DorvanFavre/dorvan/Babydoll/assets/Pasted image 20241222143701.png

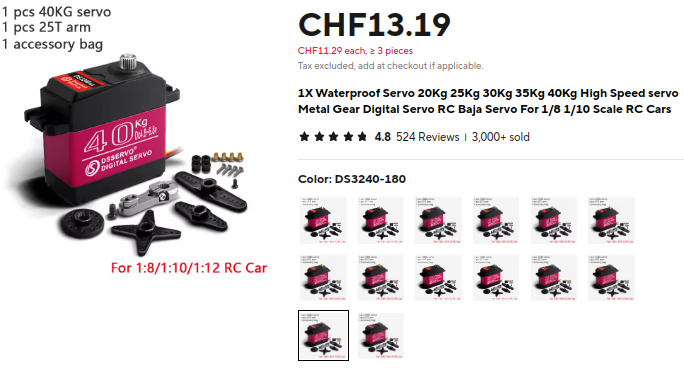
Babydoll/assets/Pasted image 20241222143701.png
