DorvanFavre/dorvan/Babydoll/Pasted image 20250105163903.png

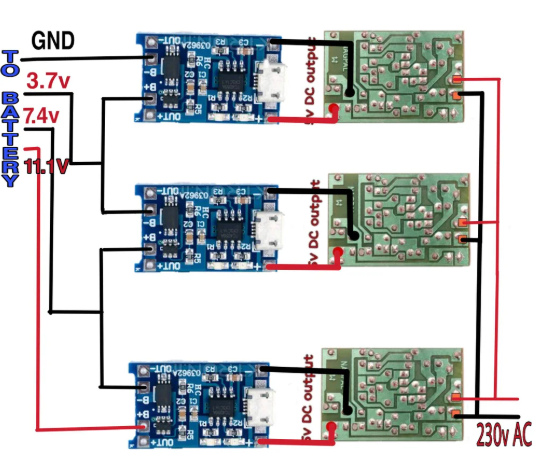
Babydoll/Pasted image 20250105163903.png
