DorvanFavre/dorvan/Babydoll/Design Hexapod.md

Servo 996R
6V : 1.3 A 

Battery:
1.3 A x 18 = 23.4 A

- [ ] Multimètre
- [ ] Fer à souder
- [ ] Soudure 
- [ ] Tresse à débraser 
- [ ] 18 servo 
- [ ] Câbles 
- [ ] Connecteurs
- [ ] roulement à bille 
- [ ] Régulateur x2 YPG 
- [ ] Chargeur de batterie
- [ ] Level converter 
- [ ] PCA9685 channel
- [ ] LM2596 régulateur 

- [ ] PLA
- [ ] Batterie
