DorvanFavre/dorvan/Babydoll/Produits/Babybot-01/Mechanical-02/Motors.md

**DS3240-180**

https://probots.co.in/ds3240-pro-40kg-high-torque-servo-motor-waterproof-metal-gear.html

![[Pasted image 20241222143701.png]]
![[Pasted image 20250108115026.png]]

Brand:Dsservo
Packing List:
1x digital servo
1x 25T adjustable metal servo arm
1x accessory bag
Apply Environmental Conditon:
1.Storage Temperature Range:-30°C~80°C
2.Operating Temperature Range:-25°C~70°C
Mechanical Specification:
1. Size: 40.0*20.5*40.5mm
2. Weight: 58g±2g
3. Limit angle: 360°
4.Bearing: 2BB
5.Horn gear spline: 25T   Diameter:5.9mm
6.Case : Engineering plastics+Aluminum alloy
7.Connector wire: 320mm±5mm
8.Motor: Carbon brush motor
Electrical Specification:
1.Working voltage range:  4.8 - 6.8V
2.Command signal: Pulse width modification
3.Amplifier type: Digital controller
4.Pulse width range: 500～2500usec
5.Neutral position: 1500usec
6.Running degree: 180±3°(PWM 500～2500usec)
or 270±3°(PWM500～2500usec)
7.Dead band width: 3 usec
8.Rotating direction Counterclockwise: (when 1000～2000usec)
## Ressources

Make your pet
https://www.youtube.com/watch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

## Test

Voltage: 6v
180 deg at full speed, no load:
3A the first 30ms
400mA afterward
env. 800ms to do 180deg

Add load draws mor current (obvious)
with quite some strength (block half the speed), draw 1A
