DorvanFavre/dorvan/Babydoll/Produits/Babybot-01/Mechanical-01/Investigate projects.md

Website to explore from:
- https://www.thingiverse.com/
- https://hackaday.io/project/171456-diy-hobby-servos-quadruped-robot

Exapode from Aecert Robotics: https://youtu.be/u-U2VmCW-e8?si=5wC6ucCFXUlxmgS2

Kit : https://www.robotshop.com/collections/hexapod-development-platforms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

 Hiwonder JetHexa ROS Hexapod Robot : 1200$

Battery: 
- 3500mAh 5C Lipo battery

Used servos:
3 per leg
20kg
HX-35H itelligent serial bus servo, Hiwonder

Bus servo controller 

Used controller:
- Arduino
- RaspberryPi 4
- Jetson nano 

Guide : https://www.esolutions.tech/how-to-build-a-hexapod-part-1-mechanics
- [ ] Look other guys 

Hexapod from MarkWTech:  https://markwtech.com/robots/hexapod/ 

Servo :
- MG996R

Level converter 

Hexapod from Leptan: https://project-leptan-docs.readthedocs.io/en/latest/index.html

Make your pet : https://github.com/MakeYourPet/hexapod/tree/main
