DorvanFavre/dorvan/Babydoll/Produits/Babybot-01/Mechanical-01/Learn inverse kinematic.md

### Ressources

Forward kinematic
https://irisdynamics.com/articles/forward-and-inverse-kinematics

https://blog.robotiq.com/how-to-calculate-a-robots-forward-kinematics-in-5-easy-steps

inverse Kinematics
https://youtu.be/D93iQVoSScQ?si=YG3vr2P5hCK57BNu
