DorvanFavre/dorvan/Babydoll/Produits/Babybot-01/Mechanical-02/Power.md

4 options:
- Contact-Based Docking Station
- Wireless Inductive Charging
- Solar charging
- Hybrid approach

## Wireless Inductive Charging

- Inductive charging module (transmitter and receiver coil)
- LiPo charging controller
- Alignment sensors (e.g., IR, ultrasonic, or camera-based)
- Temperature monitoring components (optional but recommended)

### DIY
https://www.instructables.com/DIY-Wireless-Charger-1/
https://www.instructables.com/Inductive-Charging-a-Simple-Approach-TfCD/
