DorvanFavre/dorvan/Babydoll/Produits/Babybot-01/Mechanical-02/Design Quadruped(Fusion360)/8. Design leg (Fusion 360).md

**Parameters**

Fixed components sizes (Servo, battery, screws, nuts)
Keys dimensions (member length)
Arbitrary dimensions (wall thickness, clearances)

**Components dimensions**

Battery (length, width, height): 140, 25.5, 47
Servo (length, width, height) : 40,20, 41
Servo hole distance : 4.5
Spline height: 7.9
Ballring (Outer diameter, inner diameter, width) : 11, 5, 5
Screw hole diameter: 2.2

**Key dimensions**
Coxa length: 40
Femur length: 80
Tibia length : 120

**Arbitrary diensions**

Spline clearance: 10
body spacements: 0.5
Scree clearance wall: 1.5 + screw radius
Wall thickness : 5
