DorvanFavre/dorvan/Babydoll/Organisation/Organisation.md

**Investigate**
Explore web, read paper, watch video, take note

**Learn**
Follow specific course

Title must be an objective that can be marked as done. 
"learn" is too vague. 
Choose instead:
- Power Jetson with battery
- Train agent to walk forward
- Rewrite environment according to standards
- Follow the first FlyEnv tutorials
- Find a paper that talks about CPG
