DorvanFavre/dorvan/Babydoll/Produits/Babybot-01/Informatic-01/Use camera.md

https://developer.nvidia.com/embedded/learn/jetson-orin-nano-devkit-user-guide/howto.html
camera v1.3 not working. buying v2.1
