DorvanFavre/dorvan/Babydoll/Produits/Babybot-01/Informatic-01/Credentials.md

**Jetson orin nano**
username: dorvan
password: 6956
