DorvanFavre/dorvan/Babydoll/Produits/Babybot-01/Informatic-01/Investigate VAE.md

D. Yarats, A. Zhang, I. Kostrikov, B. Amos, J. Pineau, and R. Fergus. Improving sample effi-
ciency in model-free reinforcement learning from images. arXiv preprint arXiv:1910.01741,
2019.
