DorvanFavre/dorvan/Babydoll/Produits/Babybot-01/Informatic-01/Informatic-01.md

The objective is to **train** an **RL model** to produce a simple **walk** in **simulation** and deploy it on the actual robot.

Materials
Crawling robot: https://github.com/krcarter/Reinforcement-Learning-Crawling-Robot

multiplyTransforms
changeDynamics

## Memo
