DorvanFavre/dorvan/Babydoll/Produits/Babybot-01/Informatic-01/Simulate robot and walk with IK/Simulate robot and walk with IK.md

The function `p.multiplyTransforms()` in PyBullet is used to **transform a position and orientation from one coordinate frame to another**. Specifically, it transforms a point from one frame (e.g., the robot's base frame) to another (e.g., the world frame).

### Syntax:
```python
new_position, new_orientation = p.multiplyTransforms(
    positionA, orientationA, positionB, orientationB
)
```

### Parameters:
- **`positionA`**: The position of a point in frame A (e.g., the robot’s base frame). This is a list or tuple of three values: `[x, y, z]`.
- **`orientationA`**: The orientation of frame A in quaternion format `[x, y, z, w]`. This represents the rotation of frame A relative to some reference frame.
- **`positionB`**: The position of the point in frame B that you want to transform to frame A. This is also in the form `[x, y, z]`.
- **`orientationB`**: The orientation of frame B in quaternion format `[x, y, z, w]`.

### Output:
- **`new_position`**: The transformed position in the world frame (or the frame to which you're transforming).
- **`new_orientation`**: The transformed orientation in the world frame (or the frame to which you're transforming).

### Explanation:
`p.multiplyTransforms()` applies a transformation to a position and orientation from one coordinate system (frame) to another. Here's what it does step-by-step:

1. **Rotation**: It applies the rotation of `orientationB` (frame B’s orientation) to the point in `positionB`.
2. **Translation**: It then adds the position `positionA` (frame A’s position) to the rotated point, thus transforming the point into frame A's coordinate system.

This is helpful when you want to move points or objects between coordinate systems. For example:
- Transforming a position from the robot’s base frame to the world frame.
- Combining transformations to get the final position of an object after multiple transformations.

### Example:

Imagine the robot's base frame has a position `[1, 1, 0]` and an orientation of `[0, 0, 0, 1]` (no rotation, i.e., it's aligned with the world frame). If you want to transform a point `[0.5, 0.5, 0]` in the robot's base frame into the world frame, you can do:

```python
base_position = [1, 1, 0]  # Robot's base position in world frame
base_orientation = [0, 0, 0, 1]  # Robot's base orientation (no rotation)
point_in_base = [0.5, 0.5, 0]  # Point in the robot's base frame
point_orientation = [0, 0, 0, 1]  # No rotation for the point

# Transform the point to the world frame
transformed_position, transformed_orientation = p.multiplyTransforms(
    base_position, base_orientation, point_in_base, point_orientation
)

print(f"Transformed Position: {transformed_position}")
```

This will give you the point's new position in the world frame, taking into account the robot's base position and orientation.
