DorvanFavre/dorvan/Babydoll/Produits/Babybot-01/Informatic-01/LearnJetson/JetsonPytorch/JetsonPytorch.md

Use pytorch on Jetson

- [ ] Cartpole with DQN tutorial 
https://pytorch.org/tutorials/intermediate/reinforcement_q_learning.html
