DorvanFavre/dorvan/Babydoll/assets/Pasted image 20241118151543.png

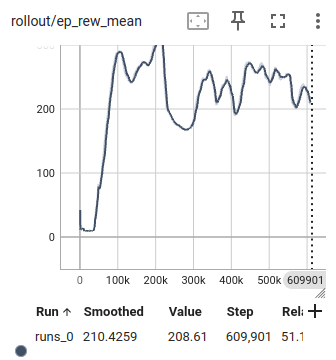
Babydoll/assets/Pasted image 20241118151543.png
