DorvanFavre/dorvan/Babydoll/assets/Pasted image 20241118154440.png

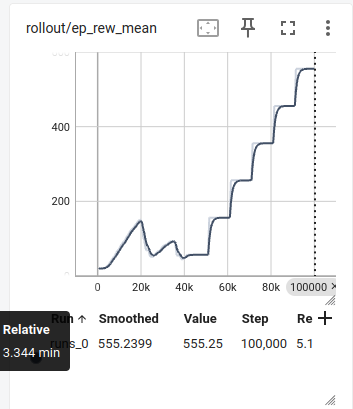
Babydoll/assets/Pasted image 20241118154440.png
