DorvanFavre/dorvan/Babydoll/assets/Pasted image 20241118185245.png

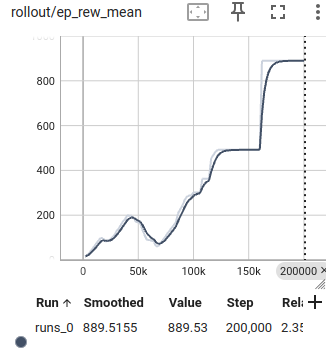
Babydoll/assets/Pasted image 20241118185245.png
