DorvanFavre/dorvan/Babydoll/assets/Pasted image 20241118190923.png

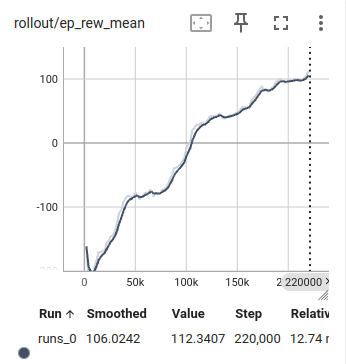
Babydoll/assets/Pasted image 20241118190923.png
