DorvanFavre/dorvan/Babydoll/assets/Pasted image 20241120112606.png

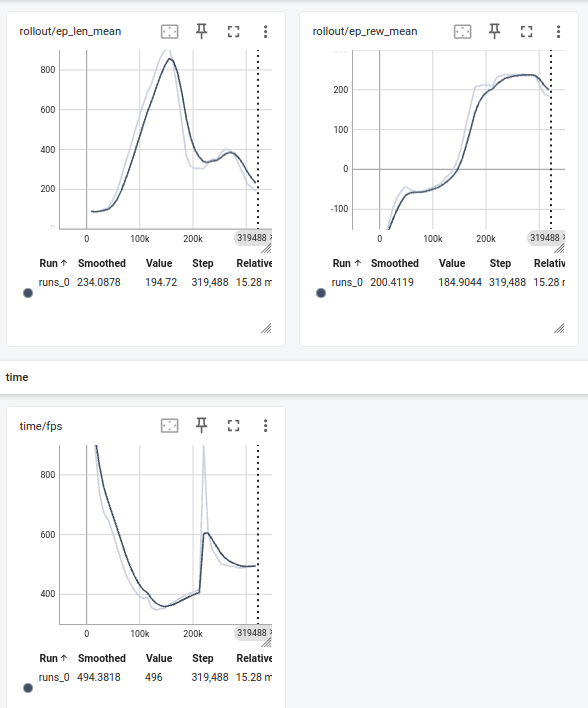
Babydoll/assets/Pasted image 20241120112606.png
