DorvanFavre/dorvan/Babydoll/assets/Pasted image 20241120125008.png

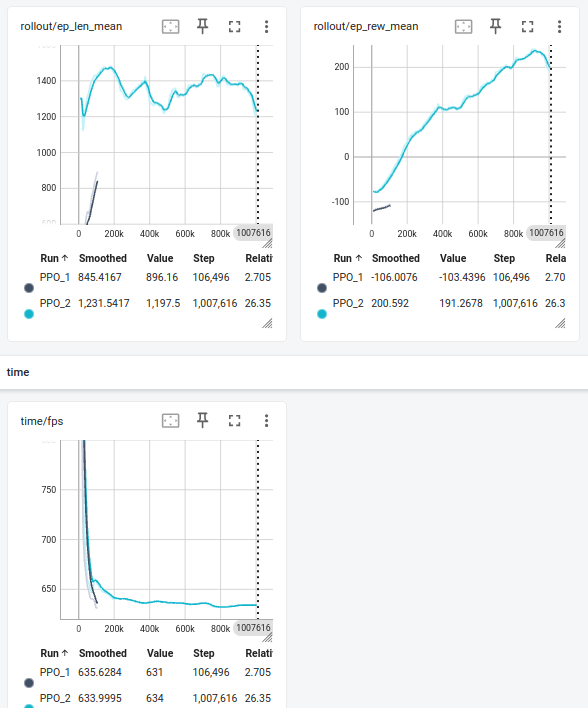
Babydoll/assets/Pasted image 20241120125008.png
