DorvanFavre/dorvan/Babydoll/assets/Pasted image 20241122143210.png

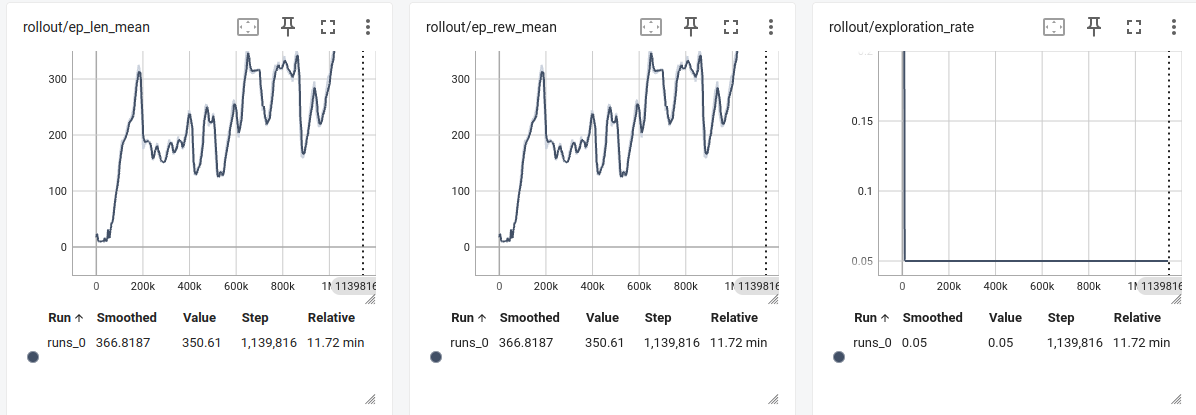
Babydoll/assets/Pasted image 20241122143210.png
