DorvanFavre/dorvan/Babydoll/assets/Pasted image 20241122150932.png

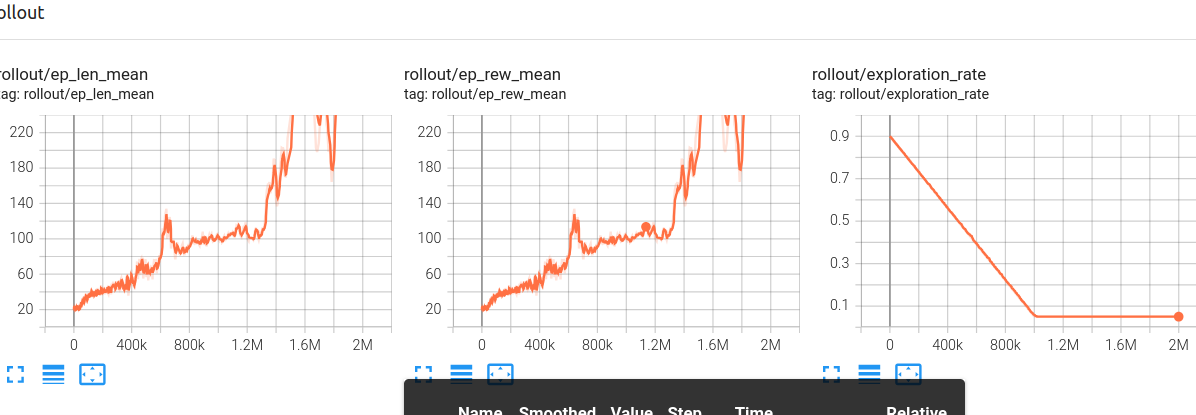
Babydoll/assets/Pasted image 20241122150932.png
