DorvanFavre/dorvan/Babydoll/assets/Pasted image 20241125190350.png

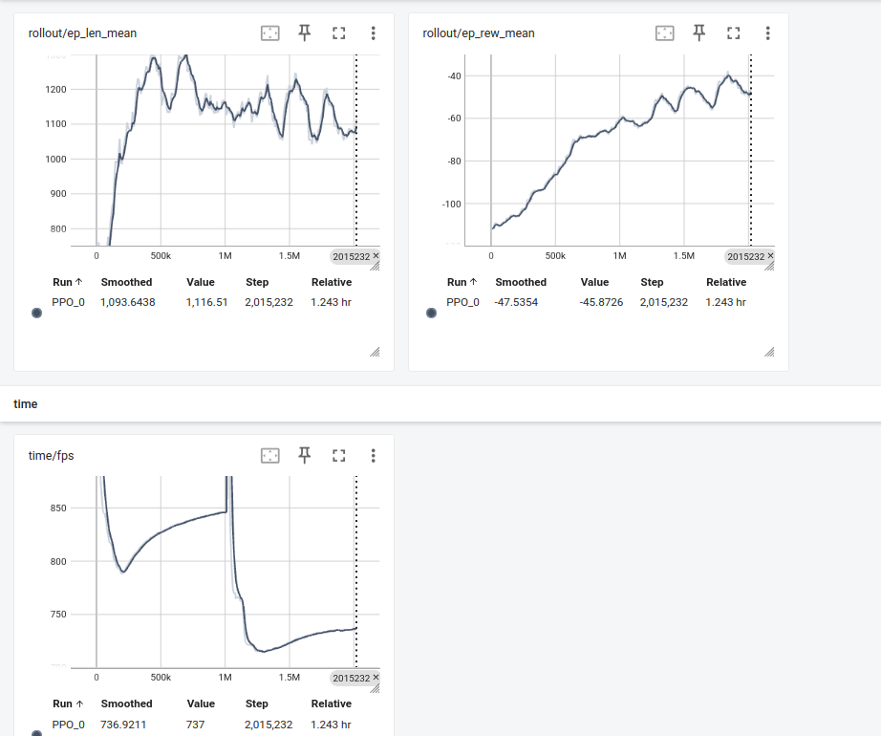
Babydoll/assets/Pasted image 20241125190350.png
