DorvanFavre/dorvan/Babydoll/assets/Pasted image 20241127165724.png

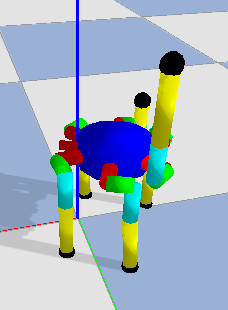
Babydoll/assets/Pasted image 20241127165724.png
