DorvanFavre/dorvan/Babydoll/assets/Pasted image 20241210105448.png

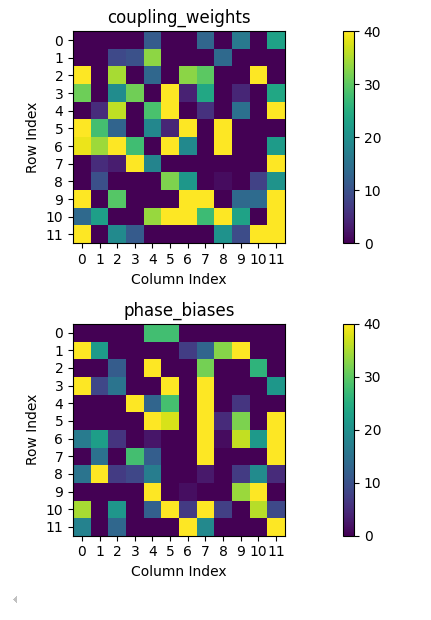
Babydoll/assets/Pasted image 20241210105448.png
