DorvanFavre/dorvan/Babydoll/assets/Pasted image 20241210132949.png

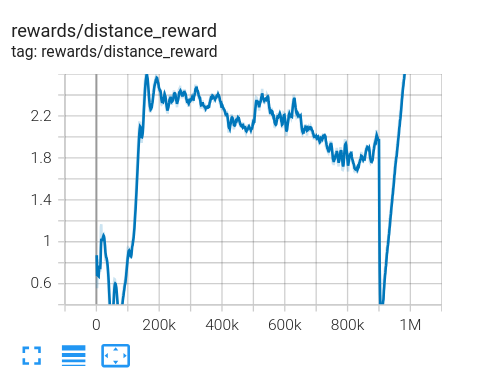
Babydoll/assets/Pasted image 20241210132949.png
