DorvanFavre/dorvan/Babydoll/assets/Pasted image 20241211143713.png

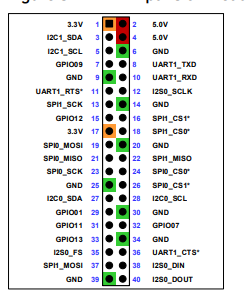
Babydoll/assets/Pasted image 20241211143713.png
