DorvanFavre/dorvan/Babydoll/assets/Pasted image 20241214112048.png

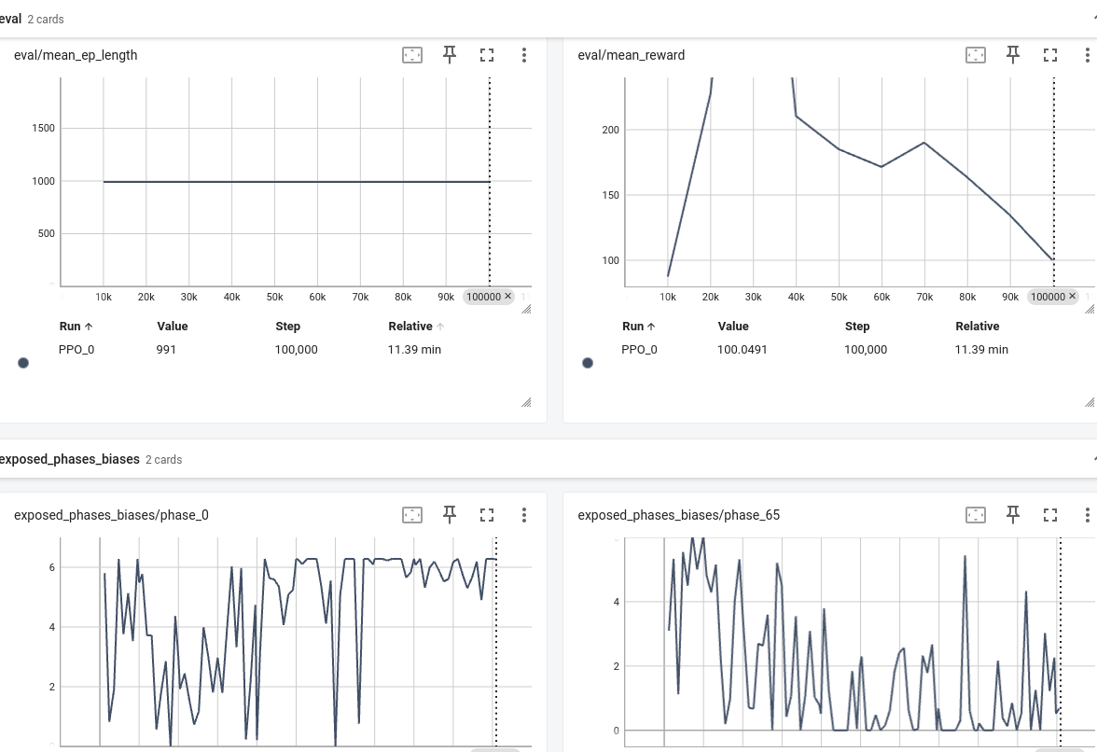
Babydoll/assets/Pasted image 20241214112048.png
