DorvanFavre/dorvan/Babydoll/assets/Pasted image 20241214154630.png

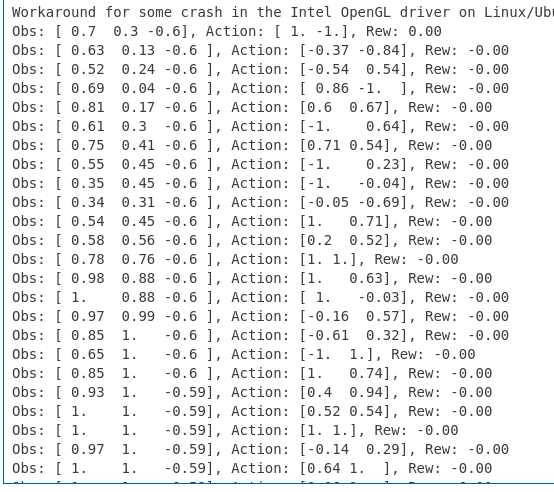
Babydoll/assets/Pasted image 20241214154630.png
