DorvanFavre/dorvan/Babydoll/assets/Pasted image 20241214175822.png

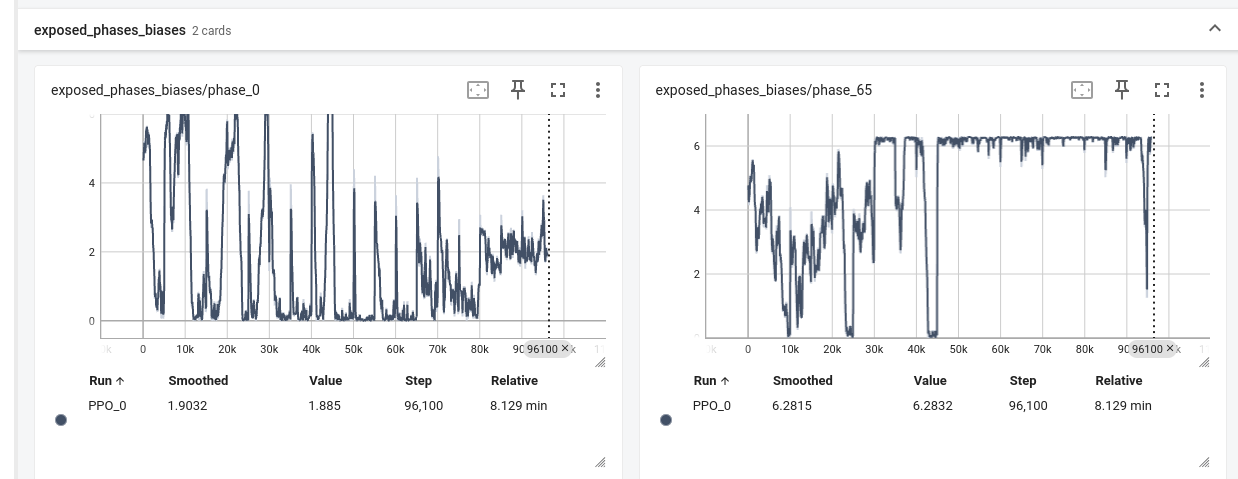
Babydoll/assets/Pasted image 20241214175822.png
