DorvanFavre/dorvan/Babydoll/assets/Pasted image 20241214183353.png

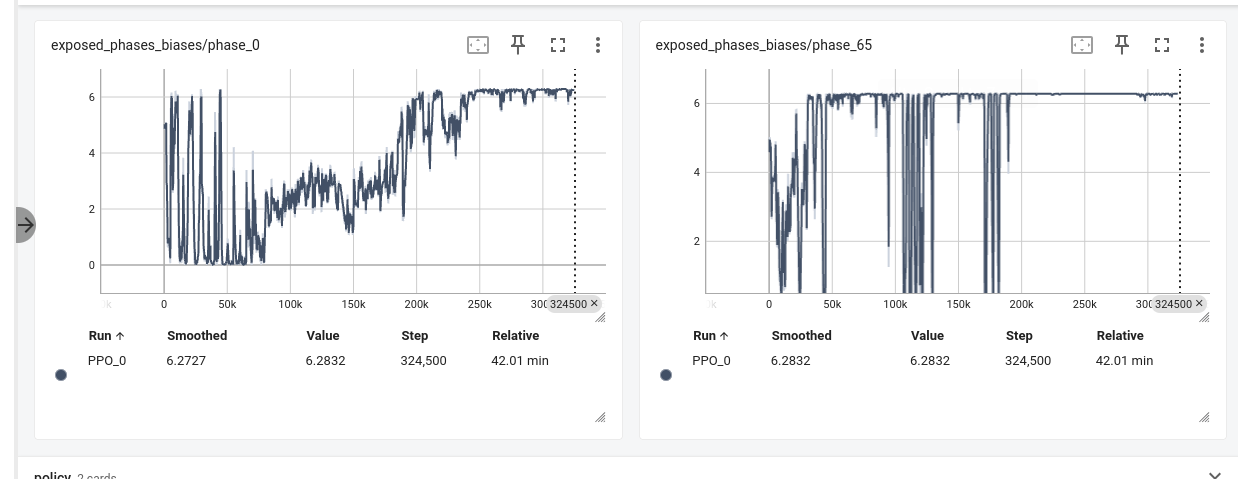
Babydoll/assets/Pasted image 20241214183353.png
