DorvanFavre/dorvan/Babydoll/assets/Pasted image 20241217094617.png

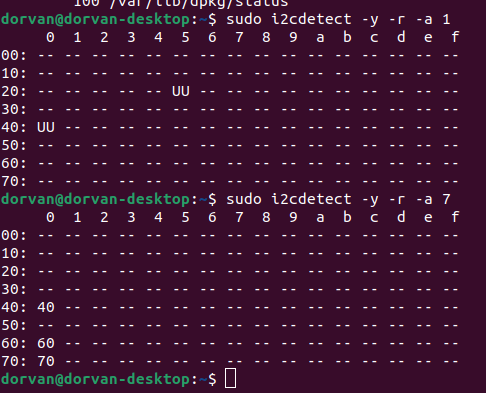
Babydoll/assets/Pasted image 20241217094617.png
