DorvanFavre/dorvan/Babydoll/assets/Pasted image 20241217094901.png

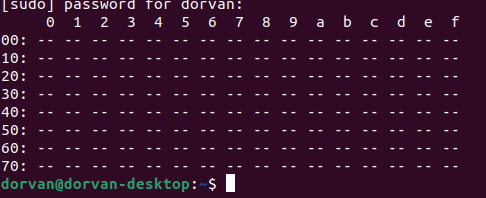
Babydoll/assets/Pasted image 20241217094901.png
