DorvanFavre/dorvan/Babydoll/assets/Pasted image 20241217095439.png

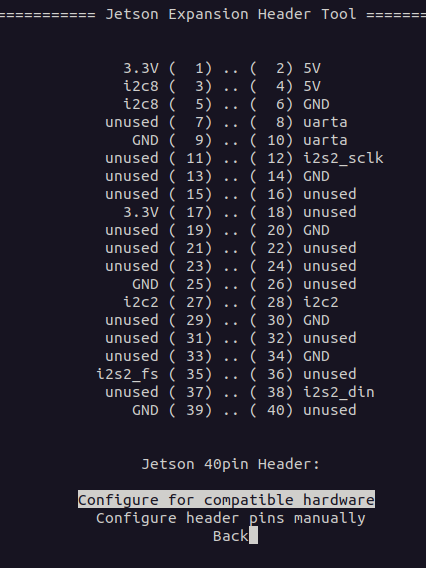
Babydoll/assets/Pasted image 20241217095439.png
