DorvanFavre/dorvan/Babydoll/assets/Pasted image 20241217095554.png

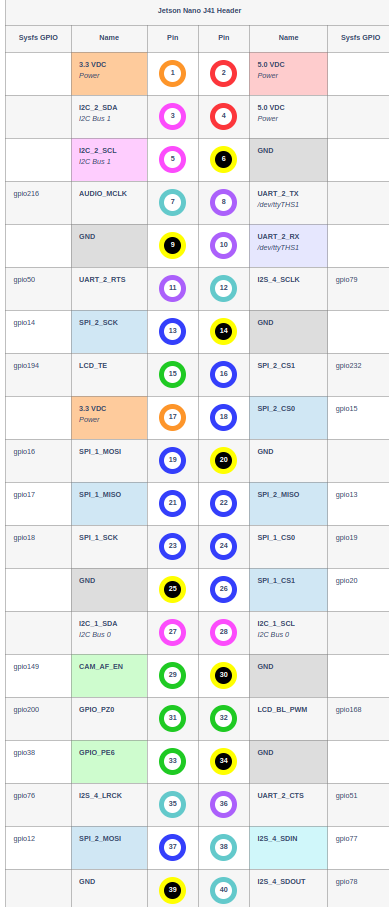
Babydoll/assets/Pasted image 20241217095554.png
