DorvanFavre/dorvan/Babydoll/assets/Pasted image 20241217100214.png

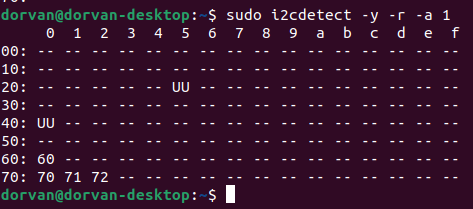
Babydoll/assets/Pasted image 20241217100214.png
