DorvanFavre/dorvan/Babydoll/assets/Pasted image 20241217120719.png

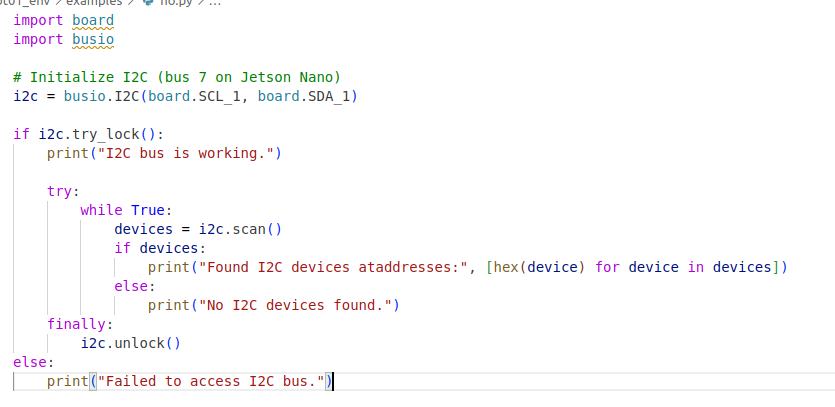
Babydoll/assets/Pasted image 20241217120719.png
