DorvanFavre/dorvan/Babydoll/assets/Pasted image 20241224125716.png

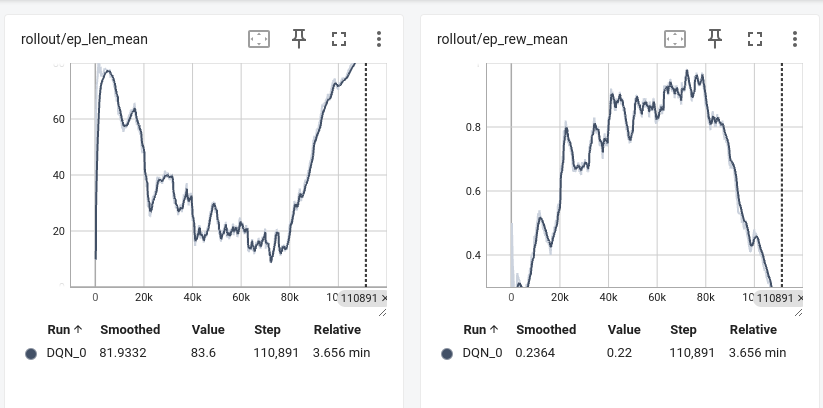
Babydoll/assets/Pasted image 20241224125716.png
