DorvanFavre/dorvan/Babydoll/assets/Pasted image 20241224131232.png

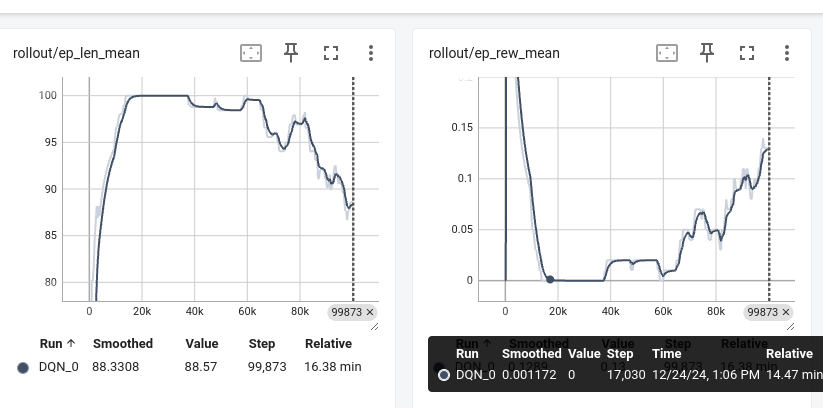
Babydoll/assets/Pasted image 20241224131232.png
