DorvanFavre/dorvan/Babydoll/assets/Pasted image 20241224131316.png

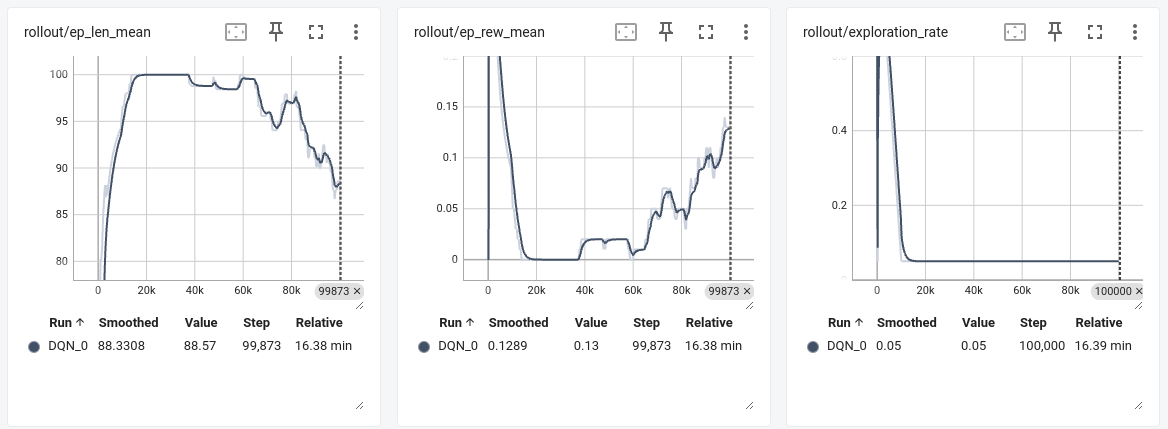
Babydoll/assets/Pasted image 20241224131316.png
