DorvanFavre/dorvan/Babydoll/assets/Pasted image 20241224131743.png

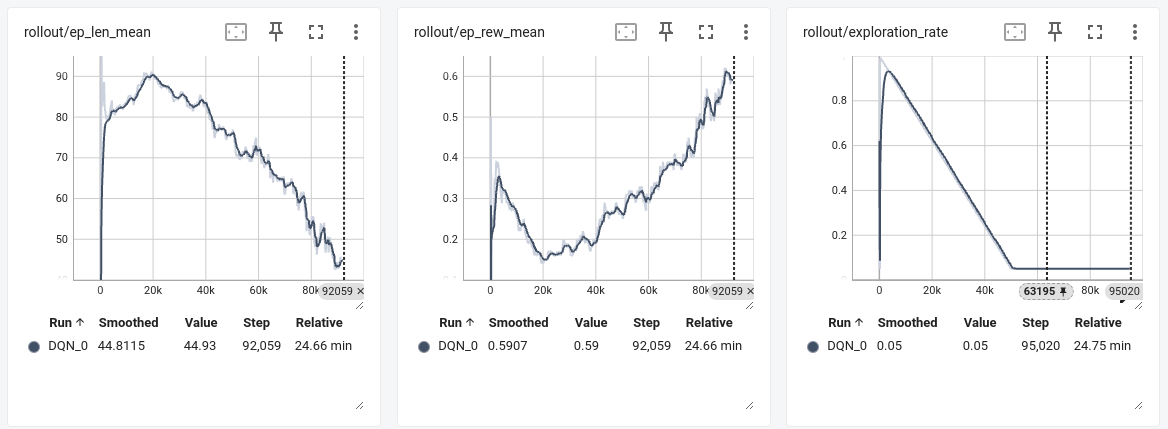
Babydoll/assets/Pasted image 20241224131743.png
