DorvanFavre/dorvan/Babydoll/assets/Pasted image 20241224132248.png

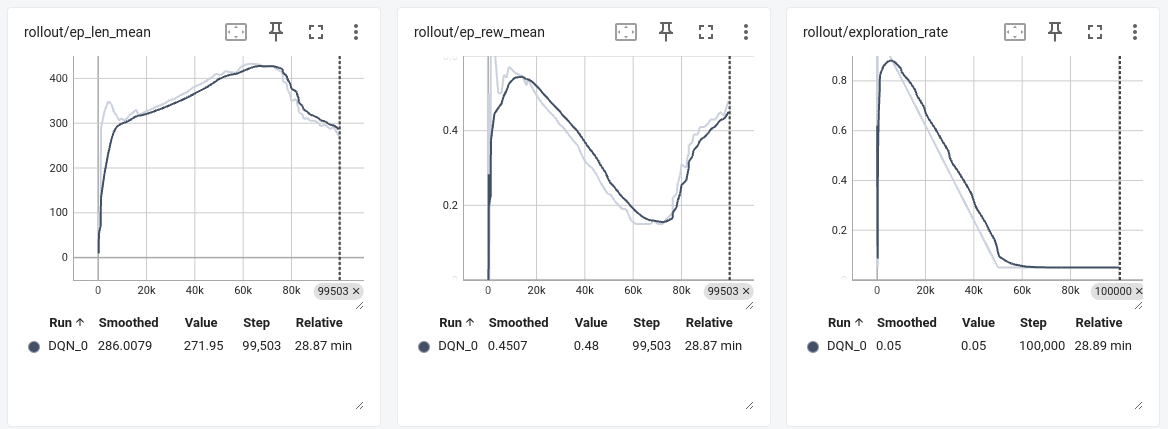
Babydoll/assets/Pasted image 20241224132248.png
