DorvanFavre/dorvan/Babydoll/assets/Pasted image 20241224132704.png

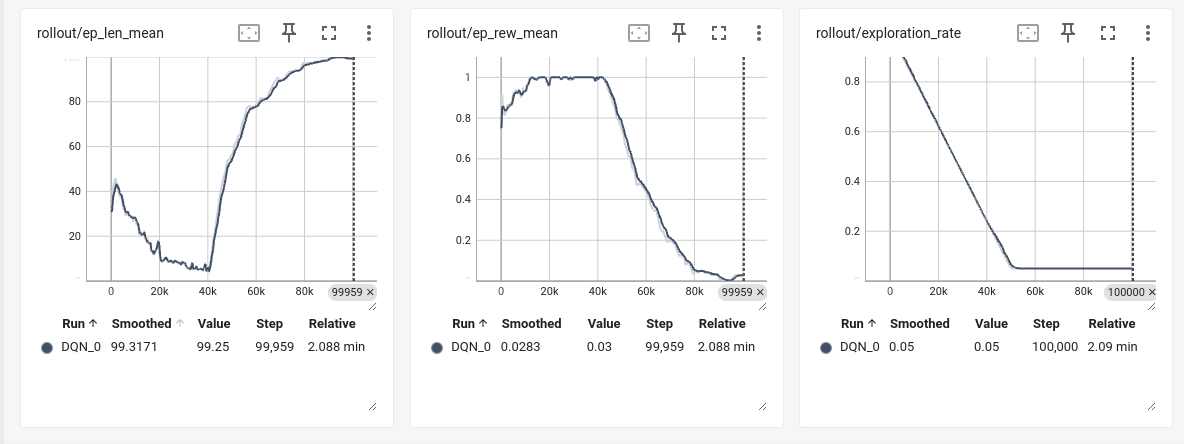
Babydoll/assets/Pasted image 20241224132704.png
