DorvanFavre/dorvan/Babydoll/assets/Pasted image 20241224135814.png

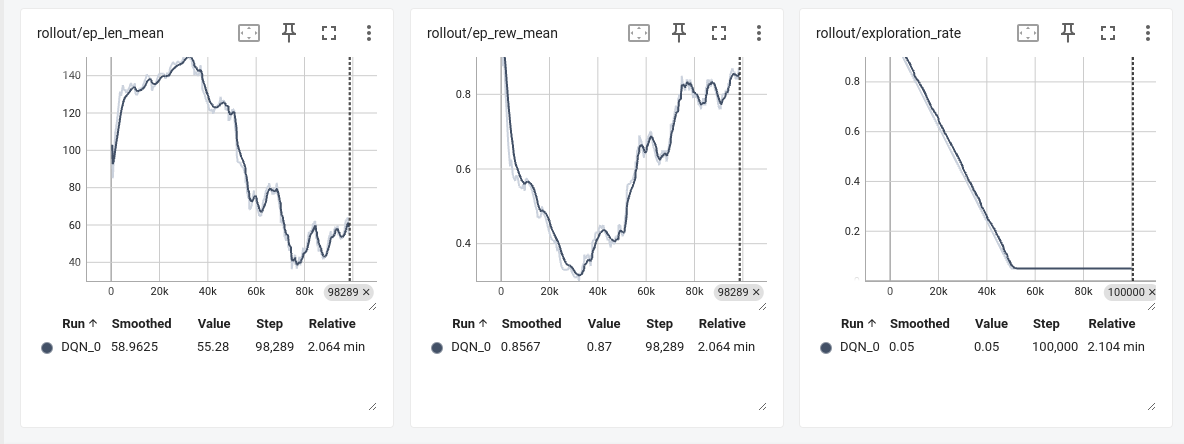
Babydoll/assets/Pasted image 20241224135814.png
