DorvanFavre/dorvan/Babydoll/assets/Pasted image 20241224141825.png

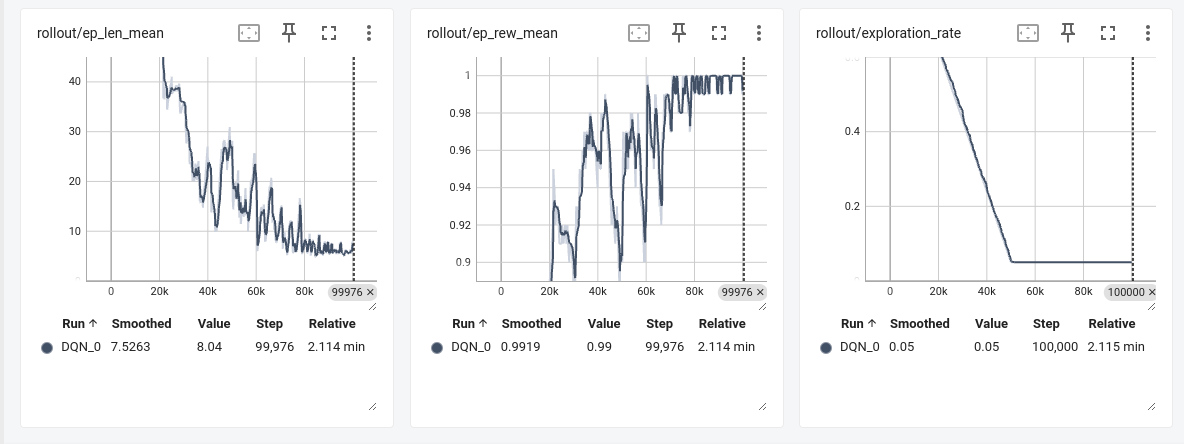
Babydoll/assets/Pasted image 20241224141825.png
