DorvanFavre/dorvan/Babydoll/assets/Pasted image 20241224161600.png

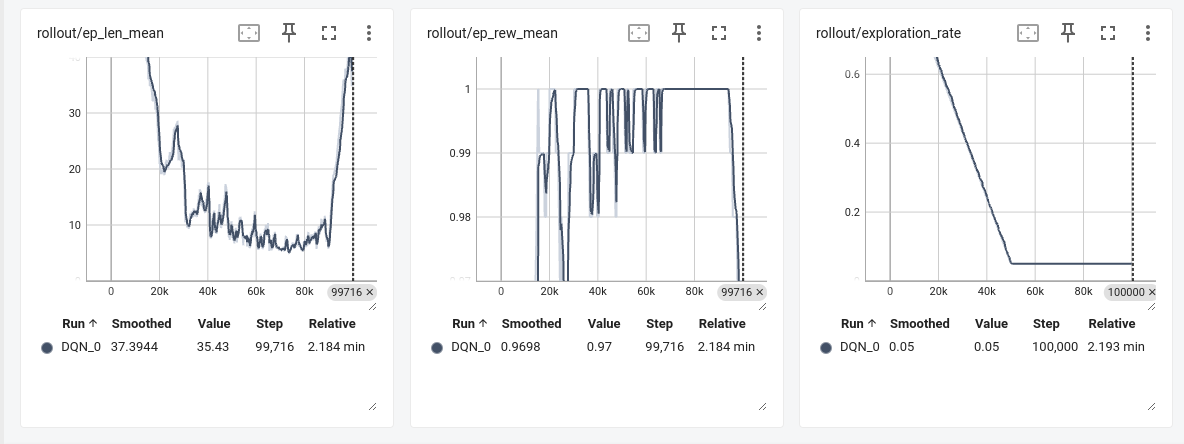
Babydoll/assets/Pasted image 20241224161600.png
