DorvanFavre/dorvan/Babydoll/assets/Pasted image 20241224164540.png

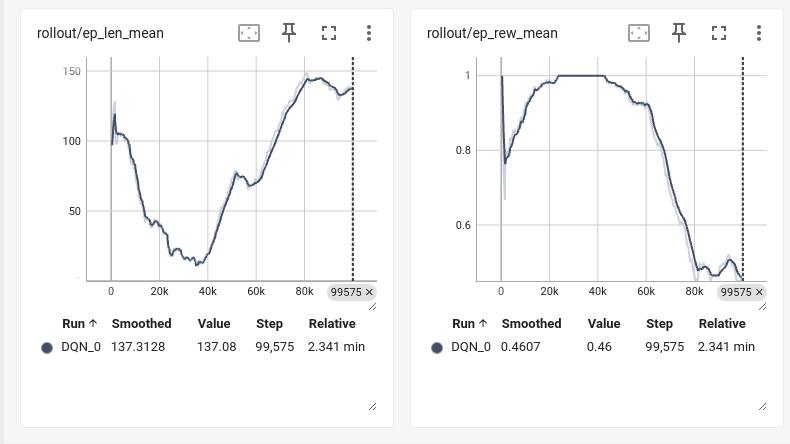
Babydoll/assets/Pasted image 20241224164540.png
