DorvanFavre/dorvan/Babydoll/assets/Pasted image 20241224170055.png

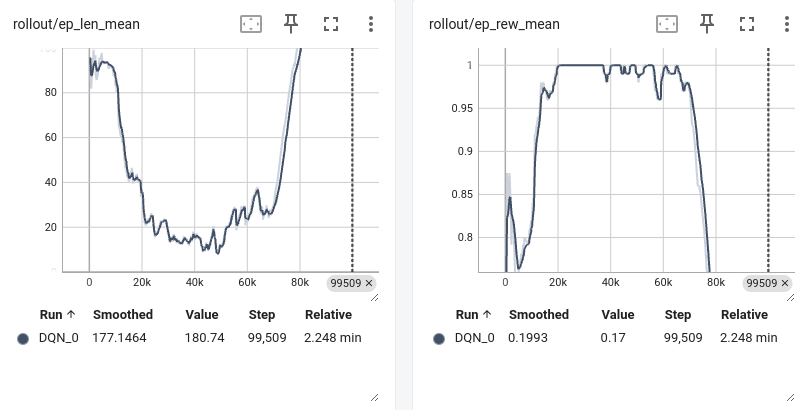
Babydoll/assets/Pasted image 20241224170055.png
