DorvanFavre/dorvan/Babydoll/assets/Pasted image 20241224173917.png

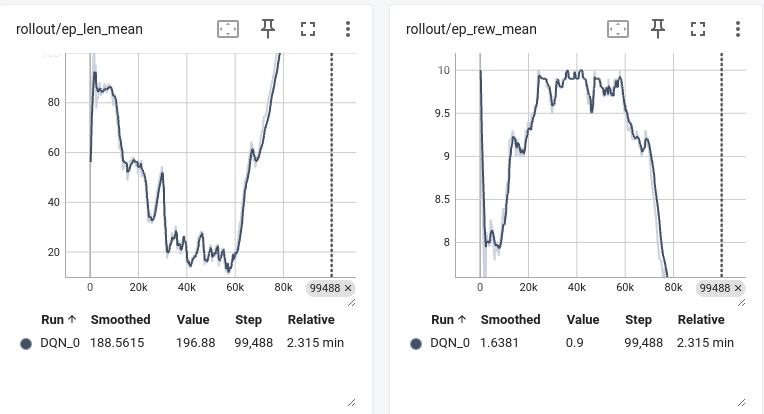
Babydoll/assets/Pasted image 20241224173917.png
