DorvanFavre/dorvan/Babydoll/assets/Pasted image 20241224174328.png

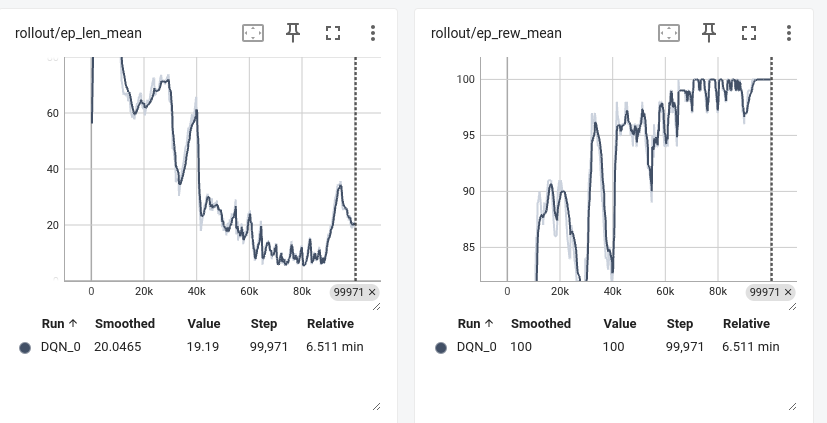
Babydoll/assets/Pasted image 20241224174328.png
