DorvanFavre/dorvan/Babydoll/assets/Pasted image 20241224174723.png

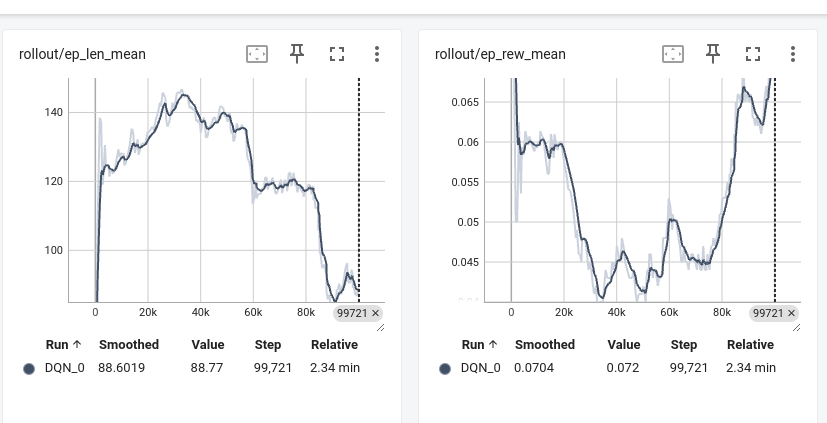
Babydoll/assets/Pasted image 20241224174723.png
