DorvanFavre/dorvan/Babydoll/assets/Pasted image 20241224175427.png

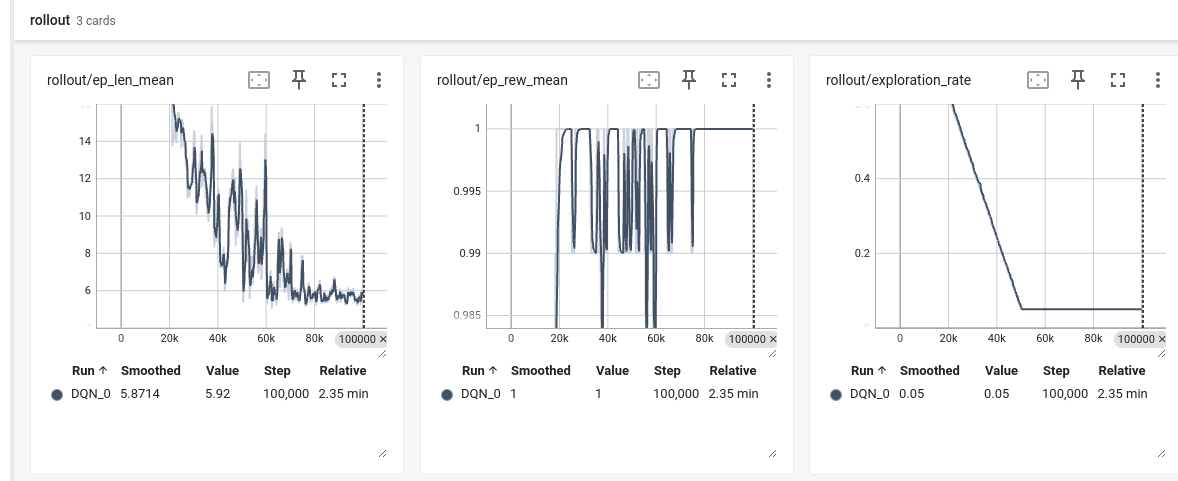
Babydoll/assets/Pasted image 20241224175427.png
