DorvanFavre/dorvan/Babydoll/assets/Pasted image 20241224180207.png

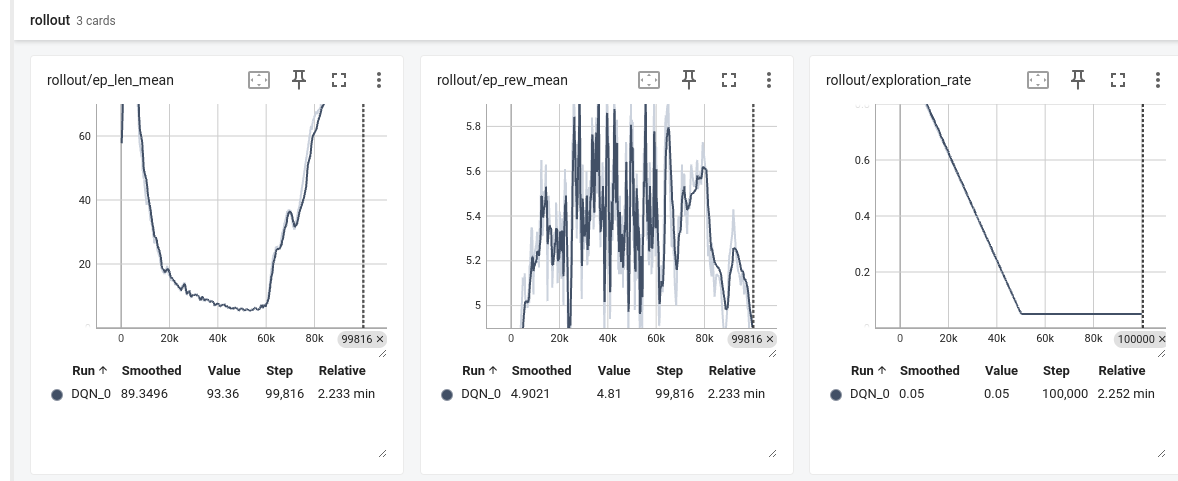
Babydoll/assets/Pasted image 20241224180207.png
