DorvanFavre/dorvan/Babydoll/assets/Pasted image 20241224180556.png

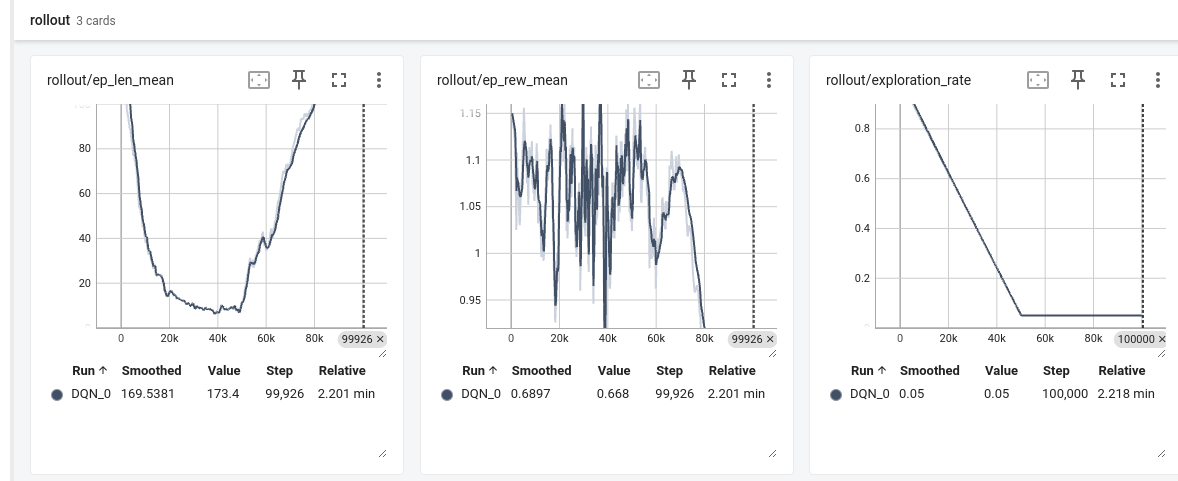
Babydoll/assets/Pasted image 20241224180556.png
