DorvanFavre/dorvan/Babydoll/assets/Pasted image 20241224181543.png

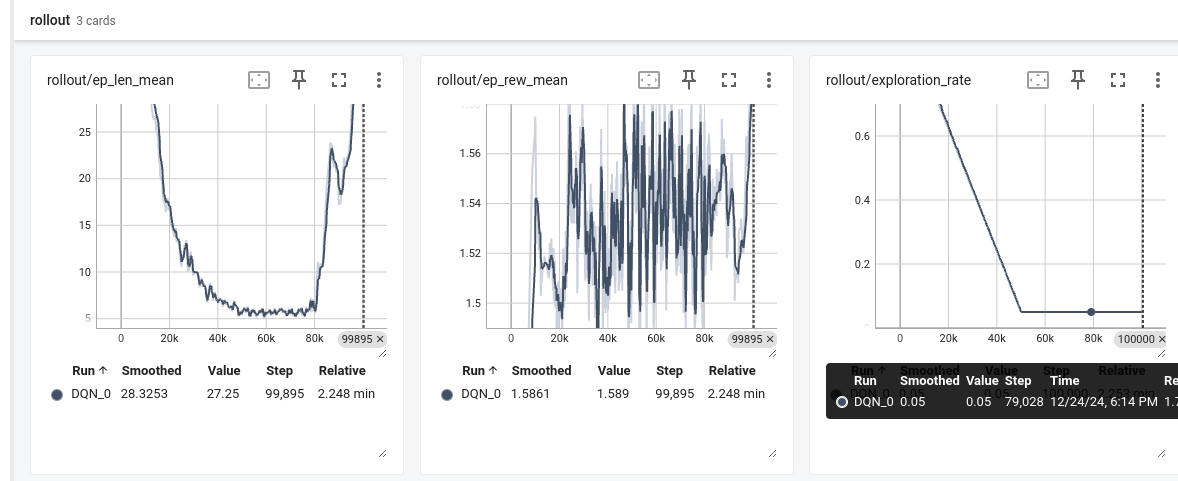
Babydoll/assets/Pasted image 20241224181543.png
