DorvanFavre/dorvan/Babydoll/assets/Pasted image 20241224182026.png

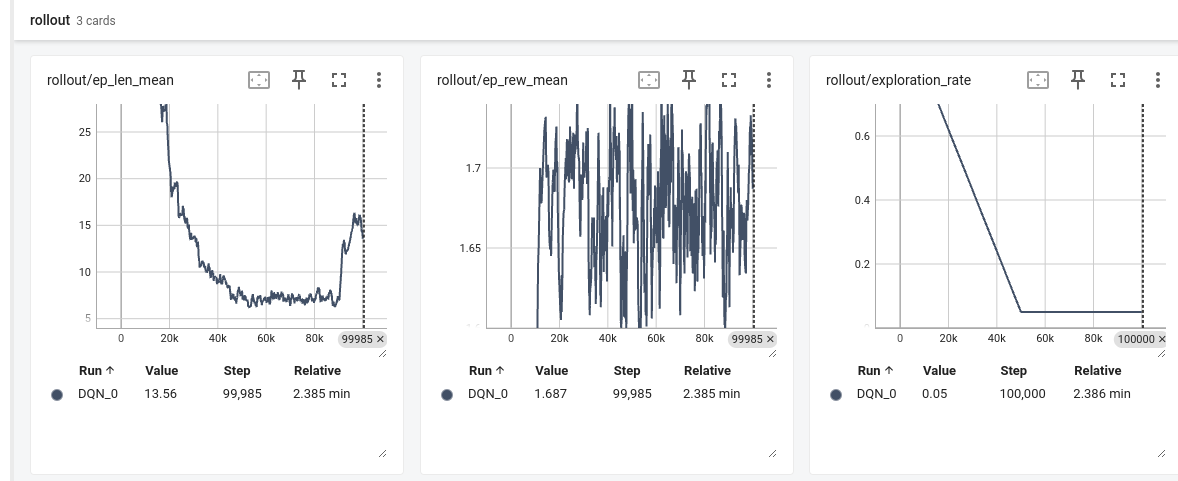
Babydoll/assets/Pasted image 20241224182026.png
