DorvanFavre/dorvan/Babydoll/assets/Pasted image 20241224182450.png

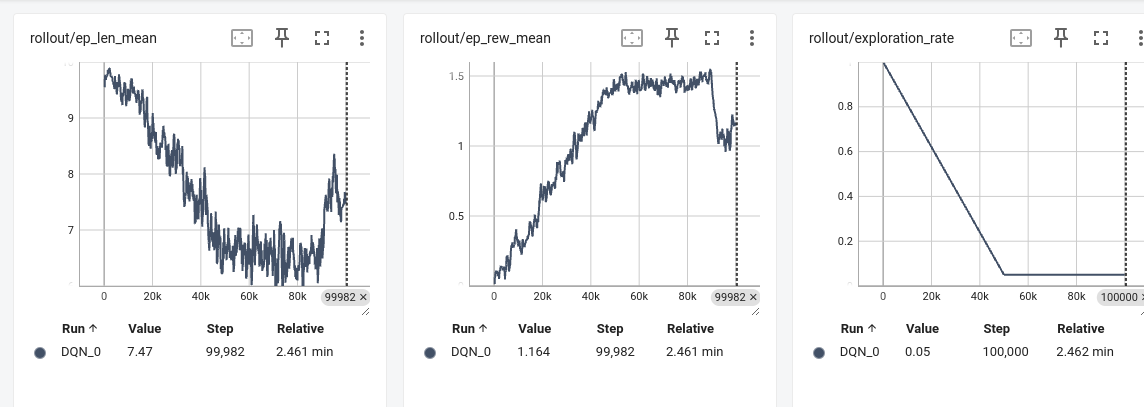
Babydoll/assets/Pasted image 20241224182450.png
