DorvanFavre/dorvan/Babydoll/assets/Pasted image 20241225090412.png

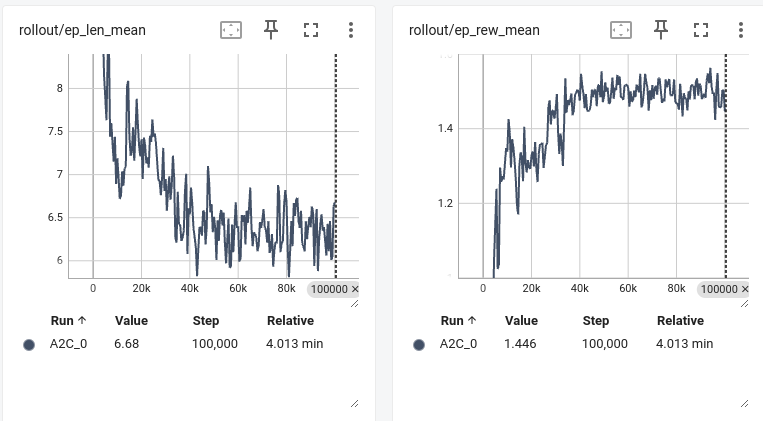
Babydoll/assets/Pasted image 20241225090412.png
