DorvanFavre/dorvan/Babydoll/assets/Pasted image 20241225100752.png

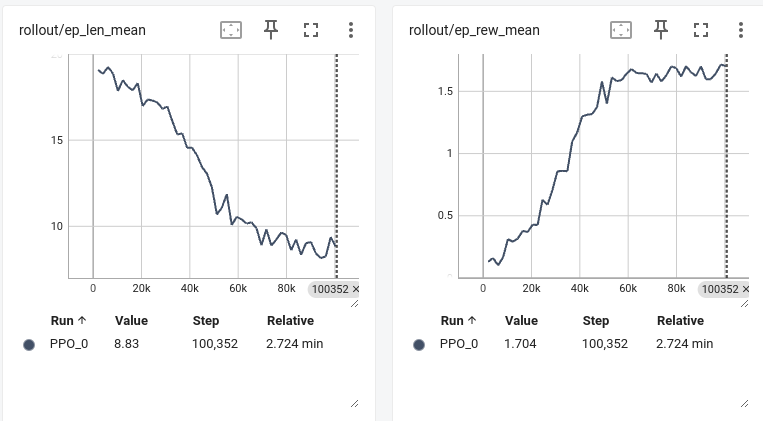
Babydoll/assets/Pasted image 20241225100752.png
