DorvanFavre/dorvan/Babydoll/assets/Pasted image 20241225101247.png

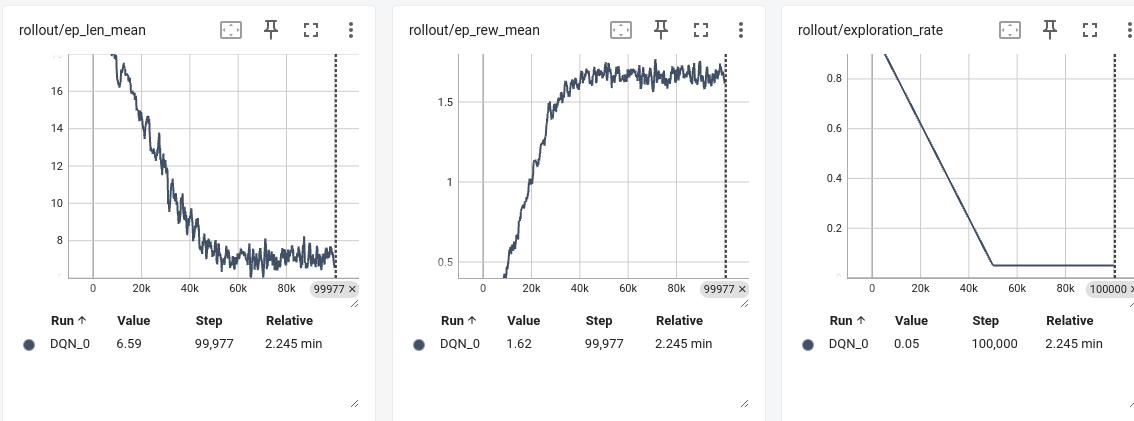
Babydoll/assets/Pasted image 20241225101247.png
