DorvanFavre/dorvan/Babydoll/assets/Pasted image 20241225103508.png

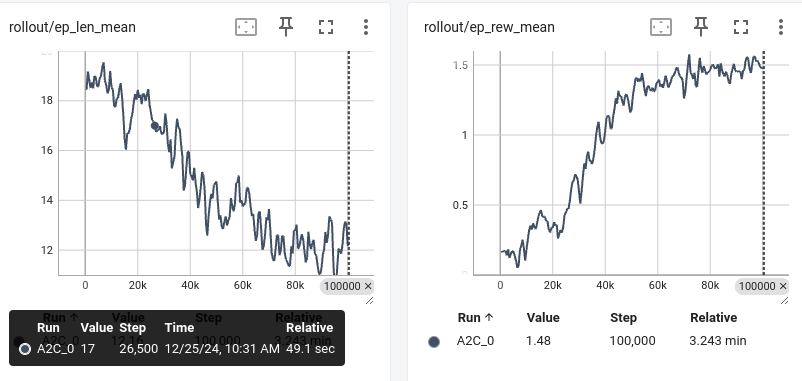
Babydoll/assets/Pasted image 20241225103508.png
