DorvanFavre/dorvan/Babydoll/assets/Pasted image 20241225105548.png

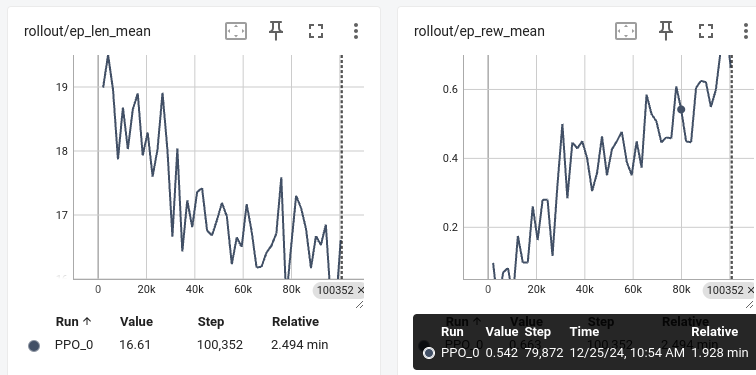
Babydoll/assets/Pasted image 20241225105548.png
