DorvanFavre/dorvan/Babydoll/assets/Pasted image 20241225110157.png

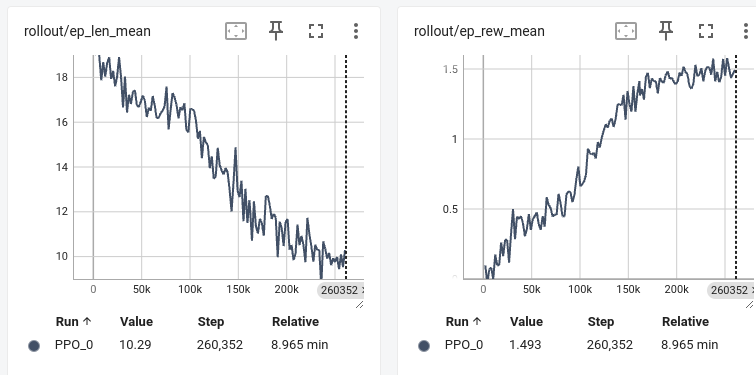
Babydoll/assets/Pasted image 20241225110157.png
