DorvanFavre/dorvan/Babydoll/assets/Pasted image 20241225113140.png

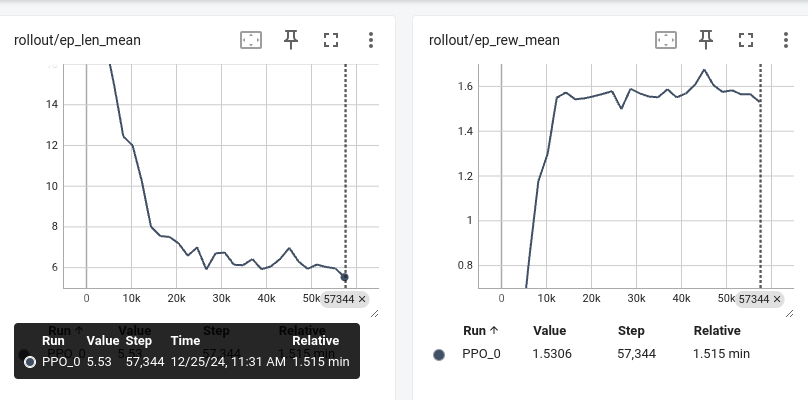
Babydoll/assets/Pasted image 20241225113140.png
