DorvanFavre/dorvan/Babydoll/assets/Pasted image 20241225134849.png

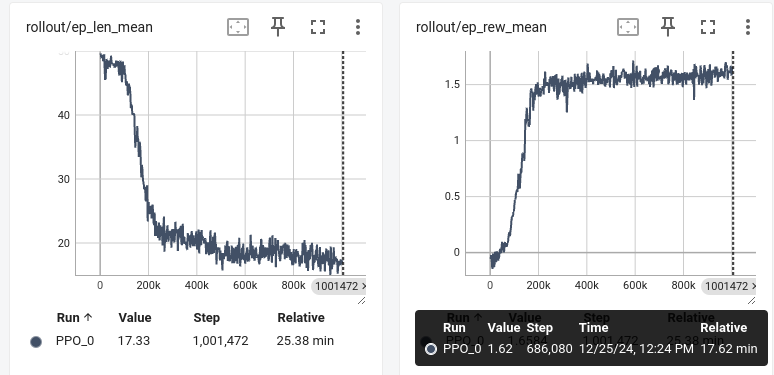
Babydoll/assets/Pasted image 20241225134849.png
