DorvanFavre/dorvan/Babydoll/assets/Pasted image 20241225140728.png

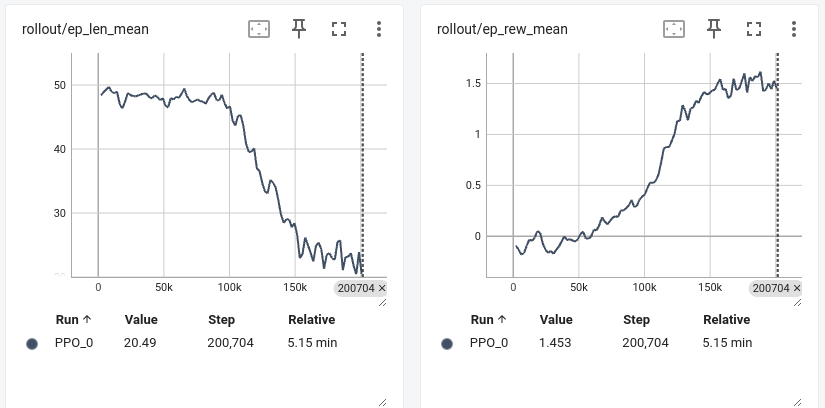
Babydoll/assets/Pasted image 20241225140728.png
