DorvanFavre/dorvan/Babydoll/assets/Pasted image 20241225141033.png

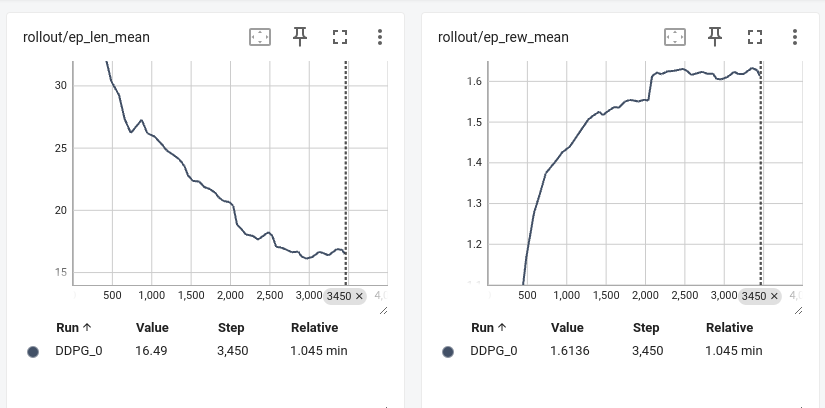
Babydoll/assets/Pasted image 20241225141033.png
