DorvanFavre/dorvan/Babydoll/assets/Pasted image 20241225141510.png

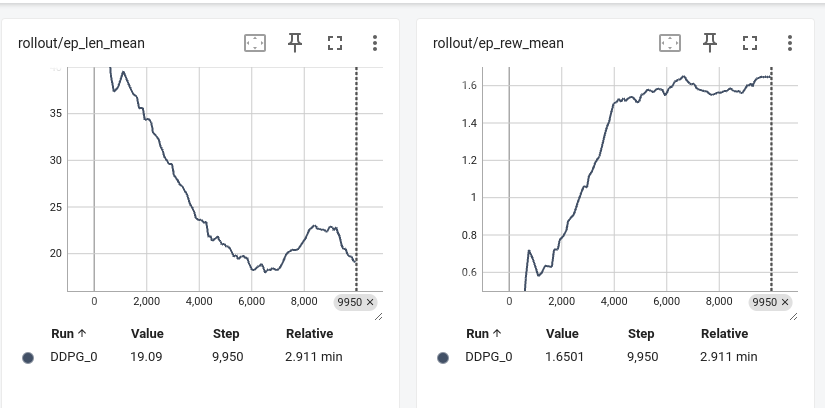
Babydoll/assets/Pasted image 20241225141510.png
