DorvanFavre/dorvan/Babydoll/assets/Pasted image 20241225142433.png

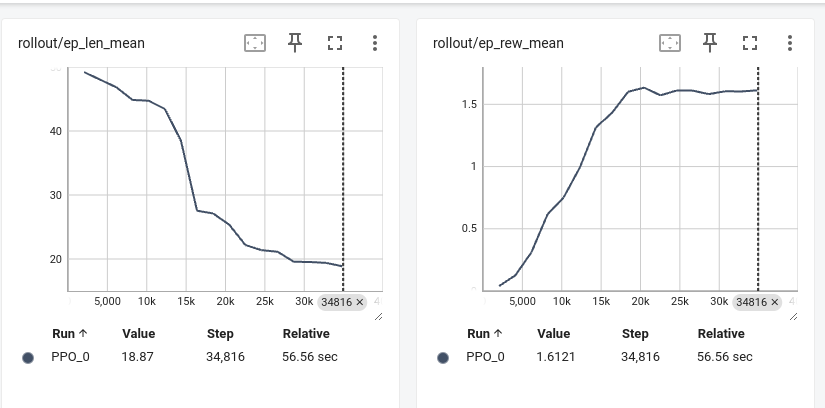
Babydoll/assets/Pasted image 20241225142433.png
