DorvanFavre/dorvan/Babydoll/assets/Pasted image 20241225151211.png

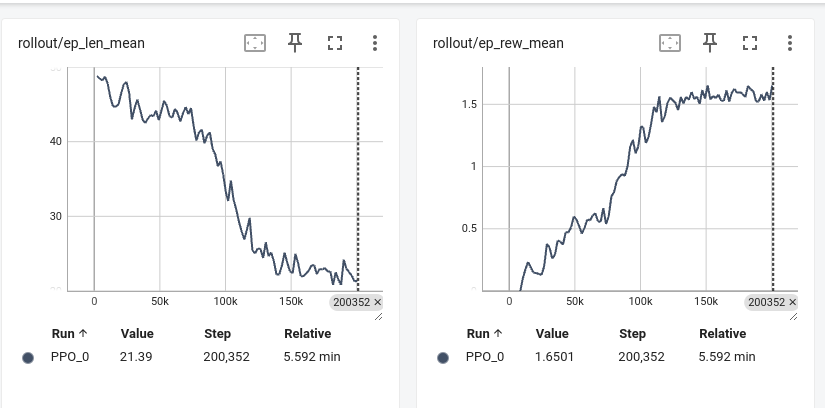
Babydoll/assets/Pasted image 20241225151211.png
