DorvanFavre/dorvan/Babydoll/assets/Pasted image 20241225152951.png

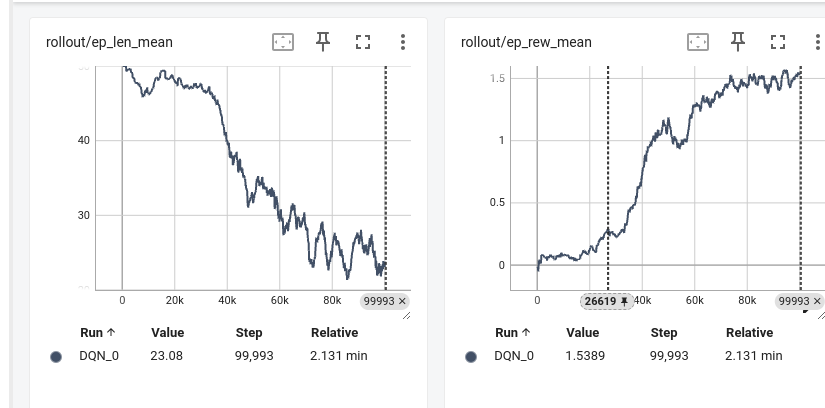
Babydoll/assets/Pasted image 20241225152951.png
