DorvanFavre/dorvan/Babydoll/assets/Pasted image 20241225155601.png

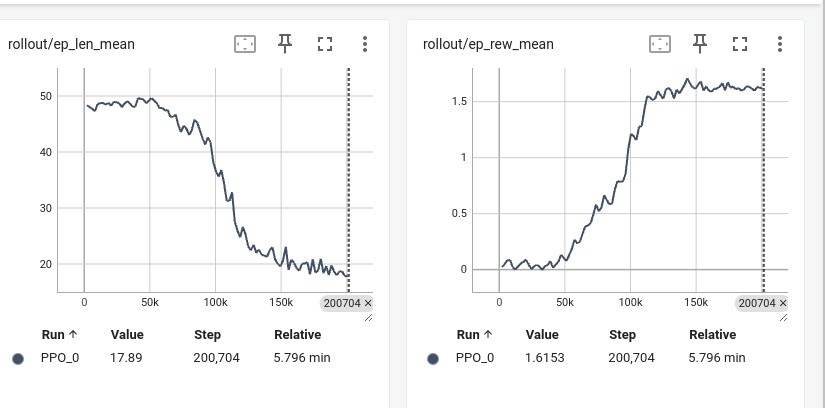
Babydoll/assets/Pasted image 20241225155601.png
