DorvanFavre/dorvan/Babydoll/assets/Pasted image 20241225163010.png

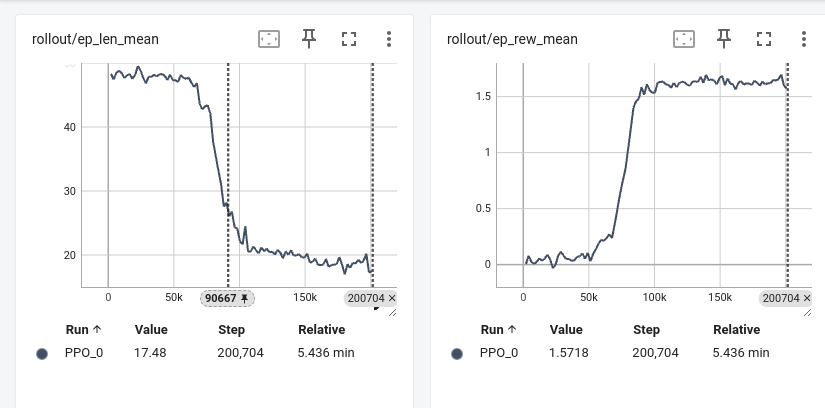
Babydoll/assets/Pasted image 20241225163010.png
