DorvanFavre/dorvan/Babydoll/assets/Pasted image 20241225163712.png

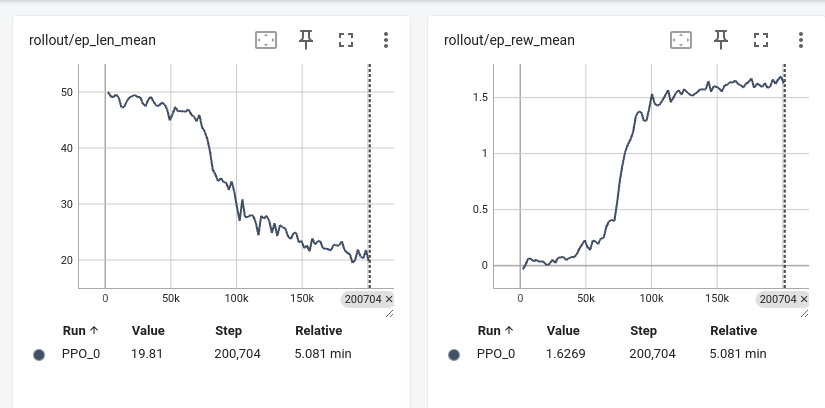
Babydoll/assets/Pasted image 20241225163712.png
