DorvanFavre/dorvan/Babydoll/assets/Pasted image 20241225164302.png

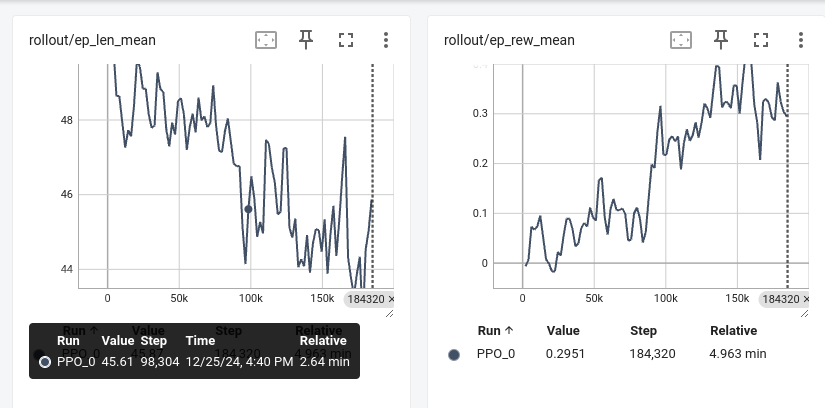
Babydoll/assets/Pasted image 20241225164302.png
