DorvanFavre/dorvan/Babydoll/assets/Pasted image 20241225165000.png

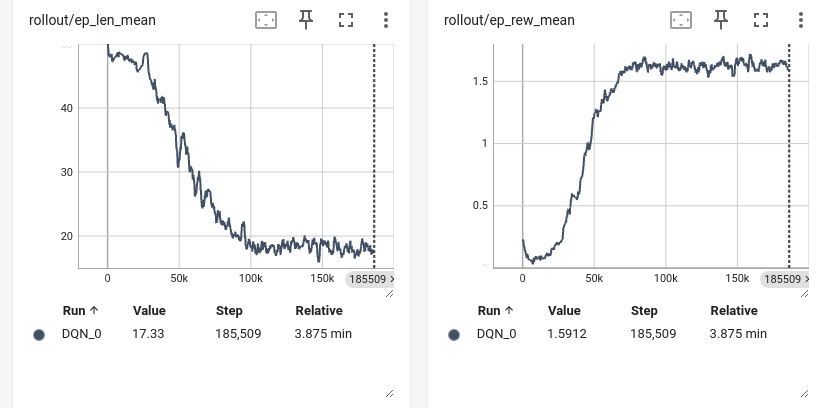
Babydoll/assets/Pasted image 20241225165000.png
