DorvanFavre/dorvan/Babydoll/assets/Pasted image 20241225165736.png

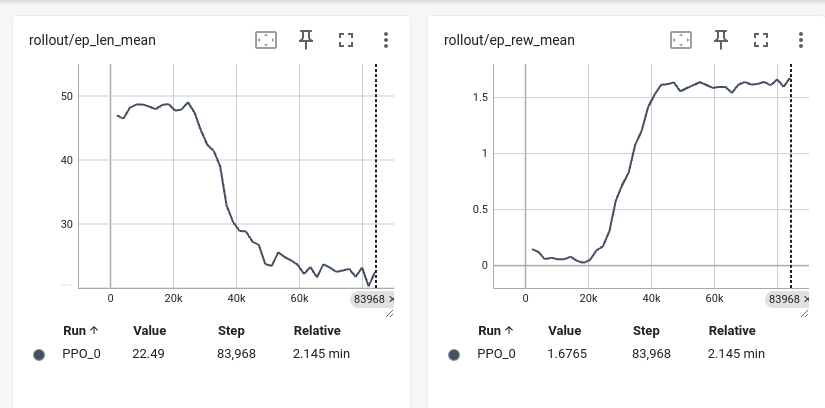
Babydoll/assets/Pasted image 20241225165736.png
