DorvanFavre/dorvan/Babydoll/assets/Pasted image 20241225170134.png

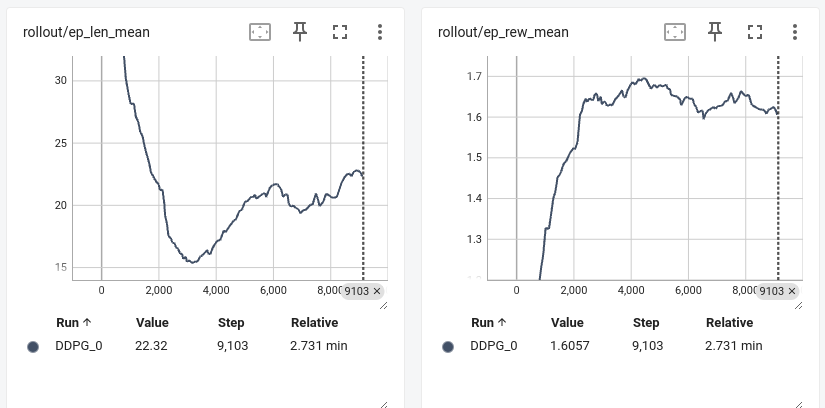
Babydoll/assets/Pasted image 20241225170134.png
