DorvanFavre/dorvan/Babydoll/assets/Pasted image 20241225170513.png

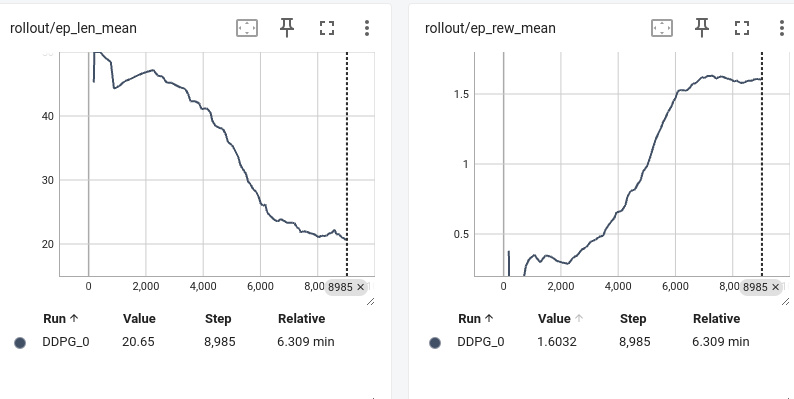
Babydoll/assets/Pasted image 20241225170513.png
