DorvanFavre/dorvan/Babydoll/assets/Pasted image 20241225171710.png

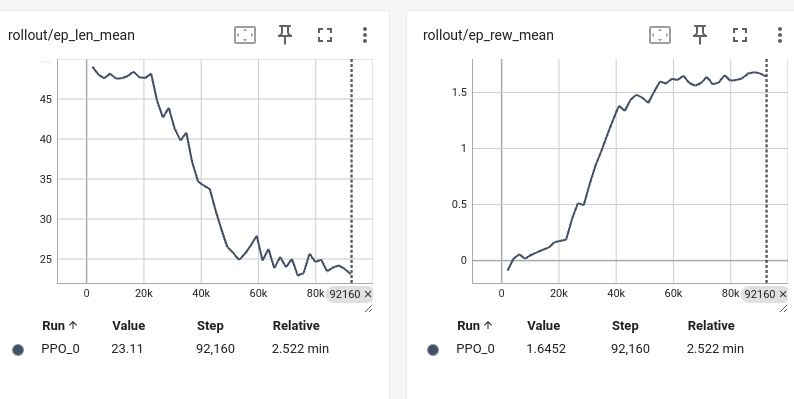
Babydoll/assets/Pasted image 20241225171710.png
