DorvanFavre/dorvan/Babydoll/assets/Pasted image 20241225172642.png

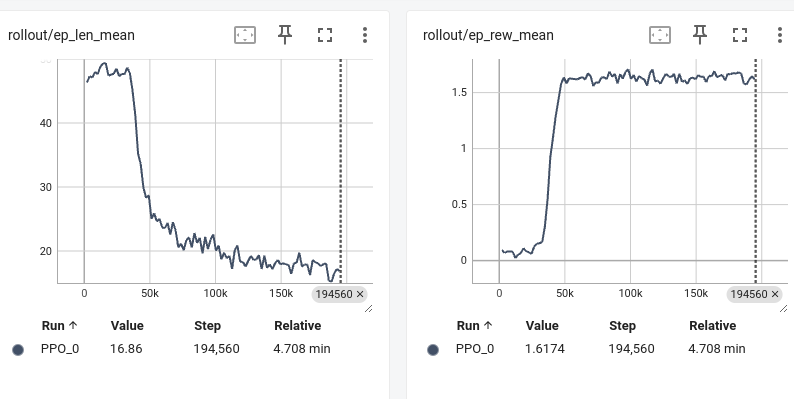
Babydoll/assets/Pasted image 20241225172642.png
