DorvanFavre/dorvan/Babydoll/assets/Pasted image 20241225173354.png

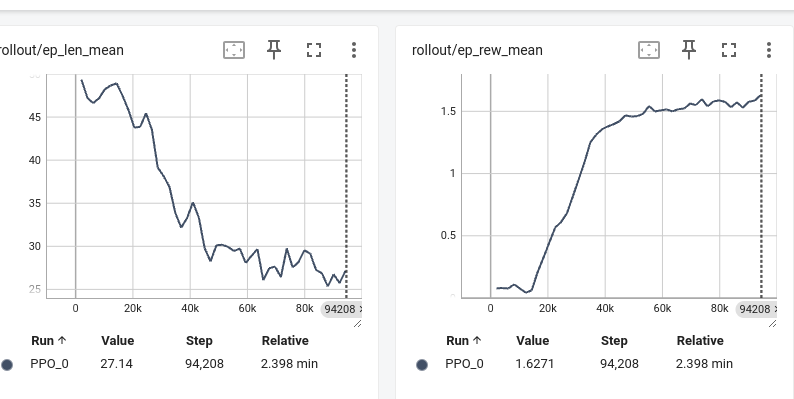
Babydoll/assets/Pasted image 20241225173354.png
