DorvanFavre/dorvan/Babydoll/assets/Pasted image 20241225173454.png

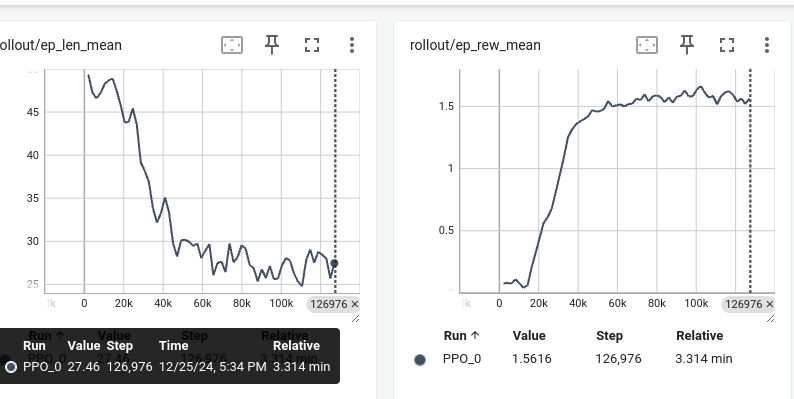
Babydoll/assets/Pasted image 20241225173454.png
