DorvanFavre/dorvan/Babydoll/assets/Pasted image 20250101145309.png

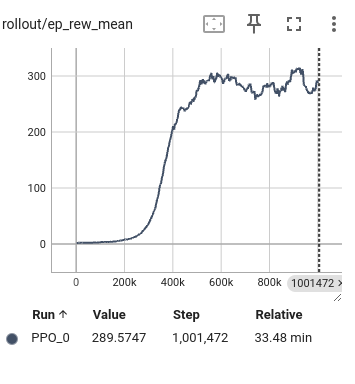
Babydoll/assets/Pasted image 20250101145309.png
