DorvanFavre/dorvan/Babydoll/assets/Pasted image 20250101171757.png

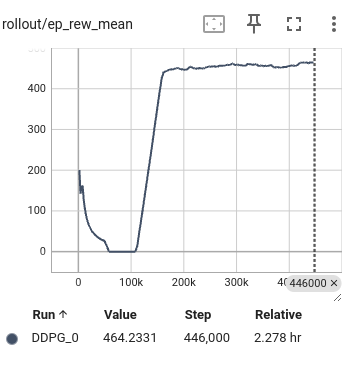
Babydoll/assets/Pasted image 20250101171757.png
