DorvanFavre/dorvan/Babydoll/assets/Pasted image 20250101185344.png

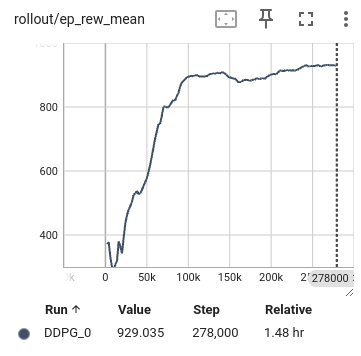
Babydoll/assets/Pasted image 20250101185344.png
