DorvanFavre/dorvan/Babydoll/assets/Pasted image 20250101195418.png

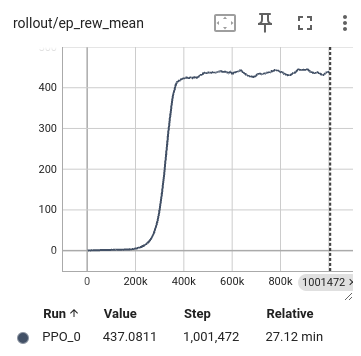
Babydoll/assets/Pasted image 20250101195418.png
