DorvanFavre/dorvan/Babydoll/Pasted image 20250108115026.png

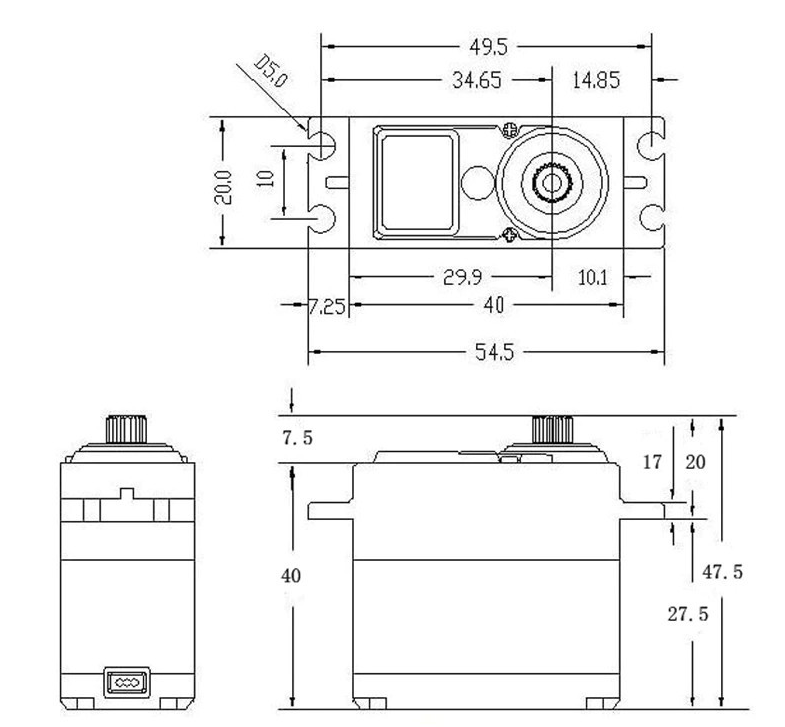
Babydoll/Pasted image 20250108115026.png
