DorvanFavre/dorvan/Babydoll/Produits/Babybot-01/Informatic-01/NeuroMechFly/outputs/cpg_controller/tripod_cpg_rollout.png

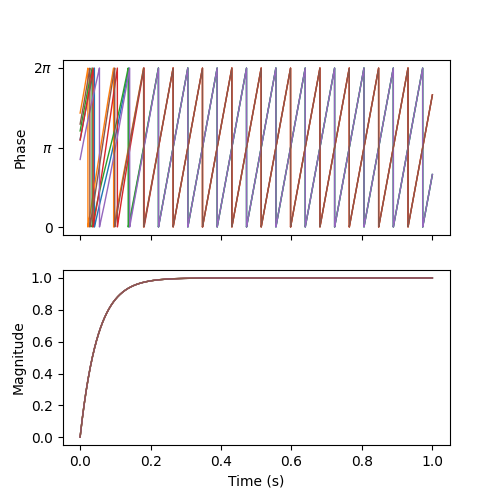
Babydoll/Produits/Babybot-01/Informatic-01/NeuroMechFly/outputs/cpg_controller/tripod_cpg_rollout.png
