DorvanFavre/dorvan/Babydoll/Produits/Babybot-01/Informatic-01/NeuroMechFly/outputs/gym_basics/kin_replay_joint_dof_time_series.png

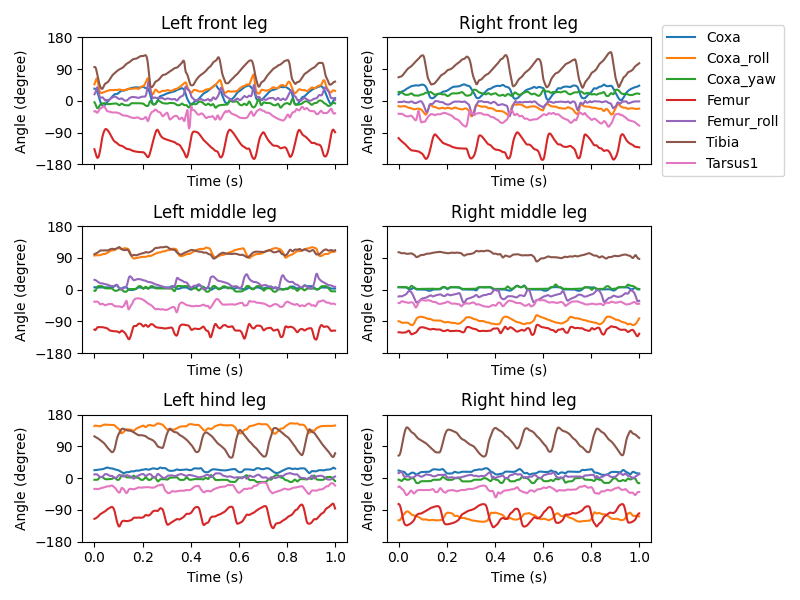
Babydoll/Produits/Babybot-01/Informatic-01/NeuroMechFly/outputs/gym_basics/kin_replay_joint_dof_time_series.png
