DorvanFavre/dorvan/Babydoll/Produits/Babybot-01/Informatic-01/NeuroMechFly/outputs/rule_based_controller/rules_graph.png

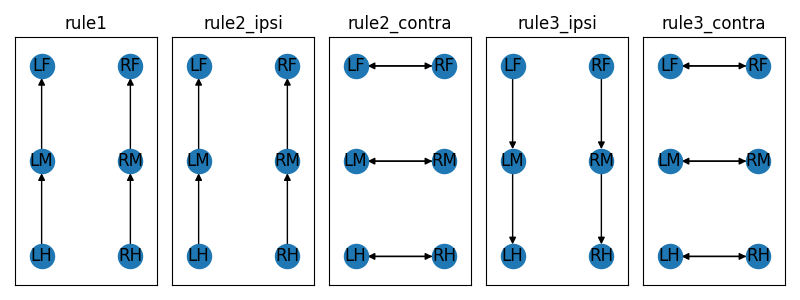
Babydoll/Produits/Babybot-01/Informatic-01/NeuroMechFly/outputs/rule_based_controller/rules_graph.png
