DorvanFavre/dorvan/Babydoll/Produits/Babybot-01/Informatic-01/WalkWithSimpleCPG/outputs/cpg_controller/simple_cpg_rollout.png

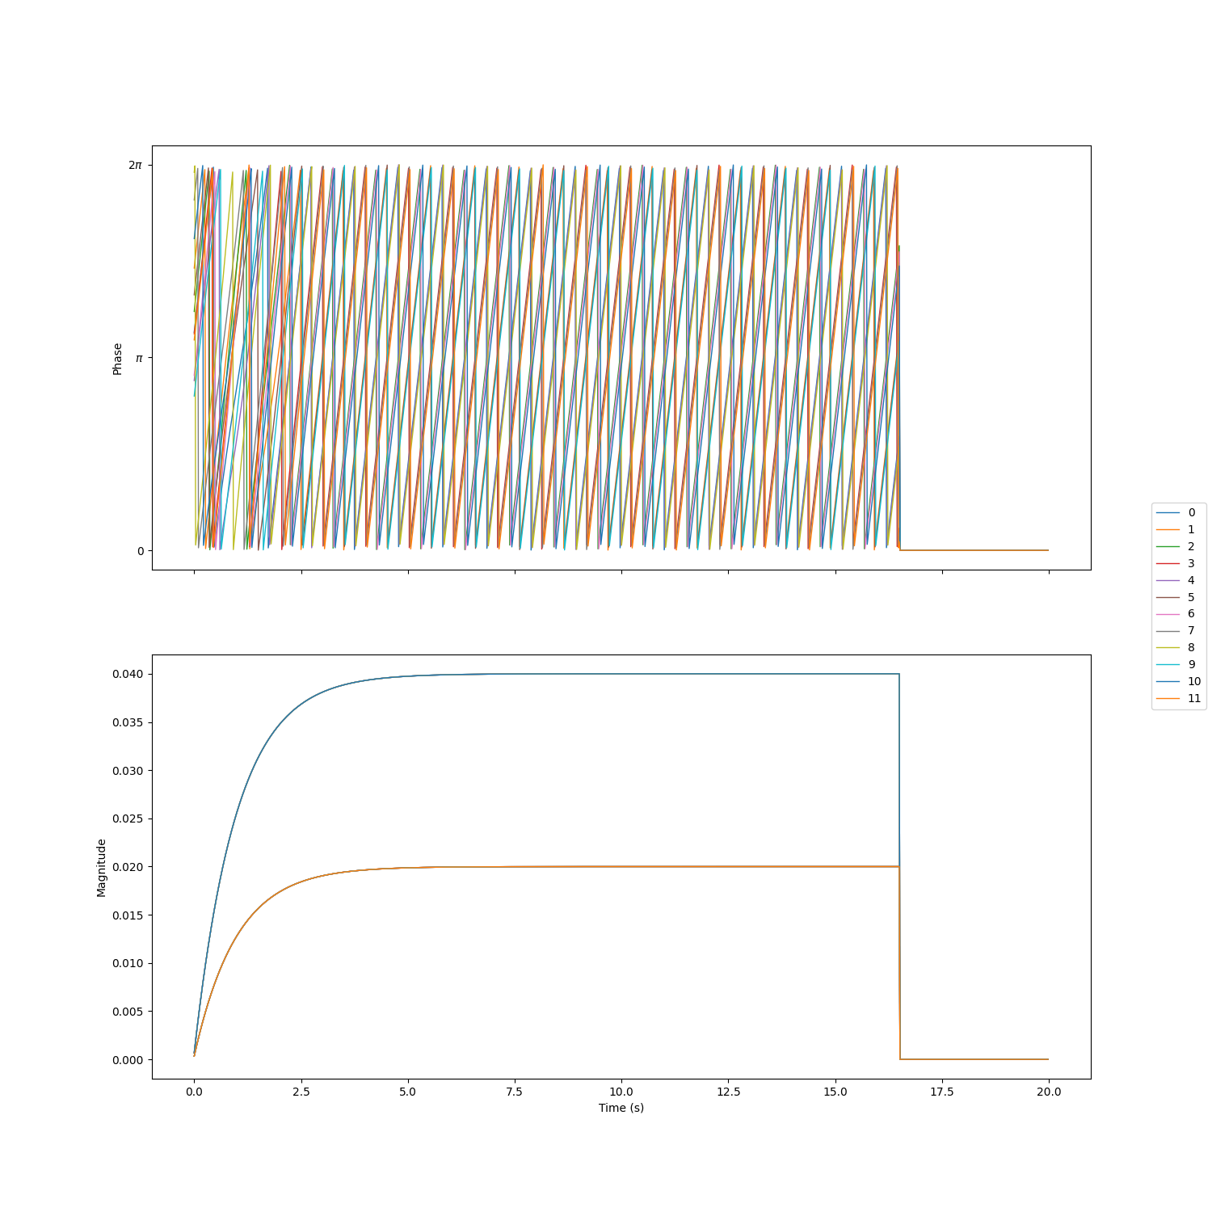
Babydoll/Produits/Babybot-01/Informatic-01/WalkWithSimpleCPG/outputs/cpg_controller/simple_cpg_rollout.png
