DorvanFavre/dorvan/Babydoll/Produits/Babybot-01/Informatic-01/Simulate robot and walk with IK/textured_sphere_smooth.obj

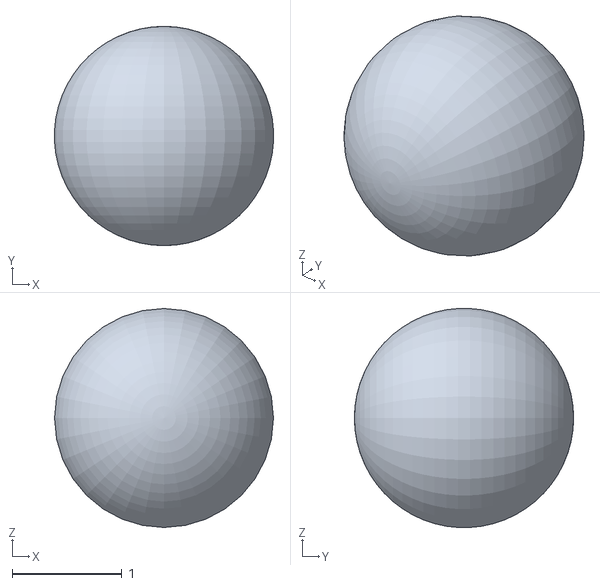
[picture p82: CAD file, 2024-11-12]
Babydoll/Produits/Babybot-01/Informatic-01/Simulate robot and walk with IK/textured_sphere_smooth.obj
2.00 x 2.00 x 2.00
