DorvanFavre/dorvan/Babydoll/Produits/Babybot-01/Mechanical-01/Design hexapod (FreeCAD)/Hexapod_v4/6xE.3mf

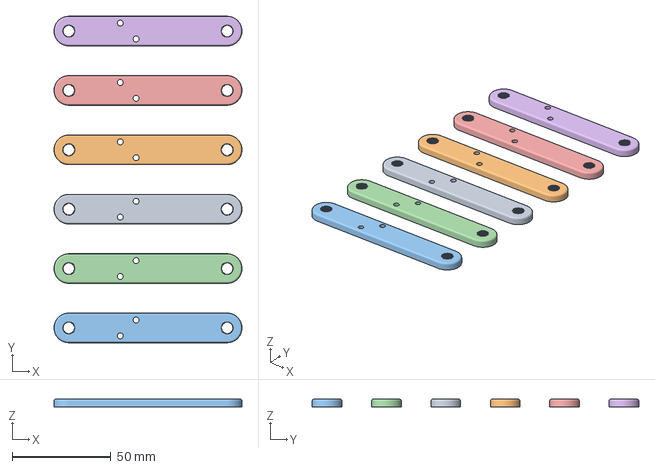
[picture p83: CAD file, 2024-12-31]
Babydoll/Produits/Babybot-01/Mechanical-01/Design hexapod (FreeCAD)/Hexapod_v4/6xE.3mf
95.0 x 165.0 x 4.00 mm
E_L_v11.stl x 3
E_R_v11.stl x 3
