DorvanFavre/dorvan/Babydoll/Produits/Babybot-01/Mechanical-01/Design hexapod (FreeCAD)/Hexapode_v3/C_v11.3mf

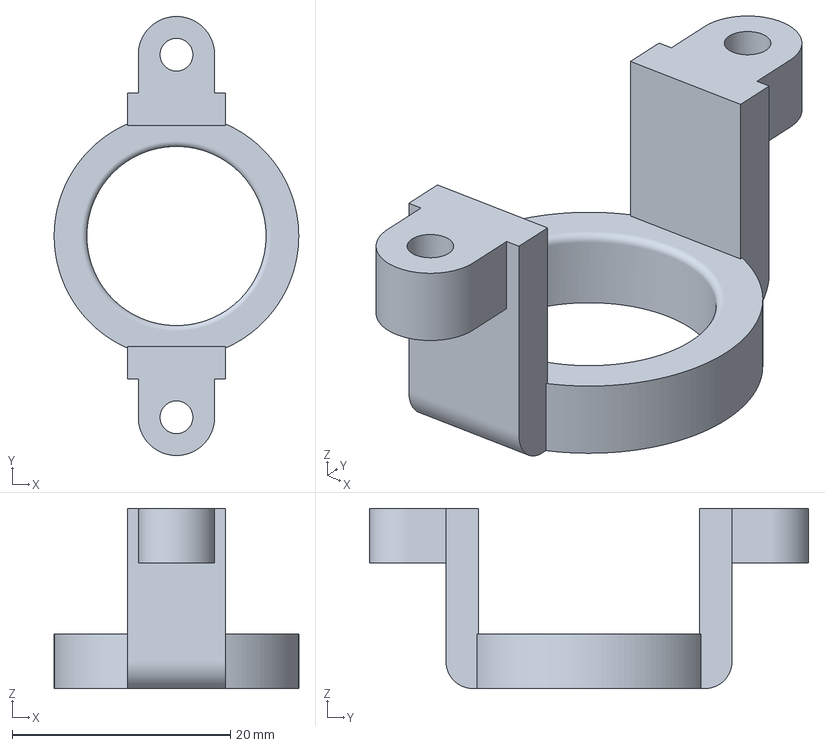
[picture p84: CAD file, 2025-01-18]
Babydoll/Produits/Babybot-01/Mechanical-01/Design hexapod (FreeCAD)/Hexapode_v3/C_v11.3mf
22.4 x 40.2 x 16.5 mm
