DorvanFavre/dorvan/Babydoll/Produits/Babybot-01/Mechanical-02/Design Quadruped(Fusion360)/Femur Spline.step

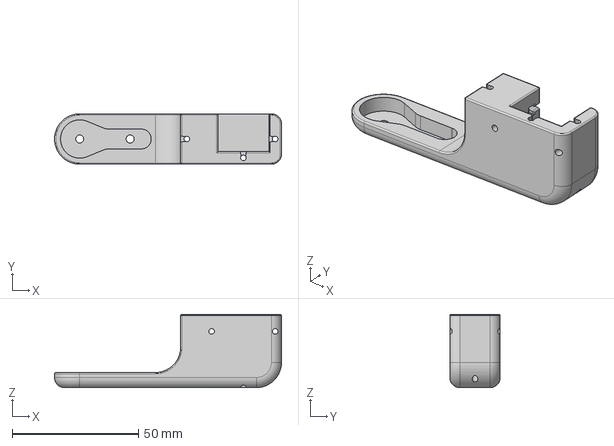
[picture p85: CAD file, 2025-01-30]
Babydoll/Produits/Babybot-01/Mechanical-02/Design Quadruped(Fusion360)/Femur Spline.step
90.0 x 20.0 x 29.1 mm
