DorvanFavre/dorvan/Babydoll/Produits/Babybot-01/Mechanical-01/Design hexapod (FreeCAD)/Hexapode_v3/E_2_R.stl

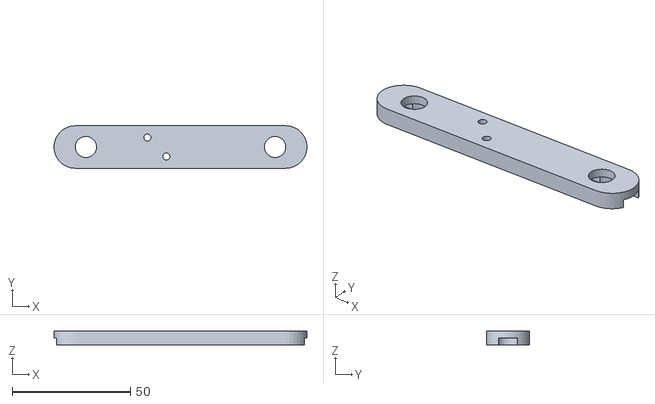
[picture p86: CAD file, 2025-01-04]
Babydoll/Produits/Babybot-01/Mechanical-01/Design hexapod (FreeCAD)/Hexapode_v3/E_2_R.stl
107.0 x 18.0 x 6.00
