DorvanFavre/dorvan/Babydoll/Produits/Babybot-01/Mechanical-02/Design Quadruped(Fusion360)/Tests v1.step

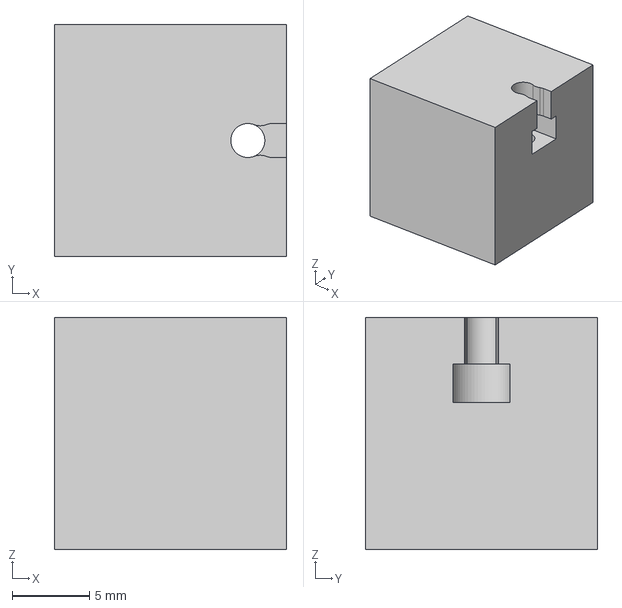
[picture p87: CAD file, 2025-01-30]
Babydoll/Produits/Babybot-01/Mechanical-02/Design Quadruped(Fusion360)/Tests v1.step
15.0 x 15.0 x 15.0 mm
