DorvanFavre/dorvan/Babydoll/Produits/Babybot-01/Mechanical-01/Design hexapod (FreeCAD)/Hexapode_v3/Hexapod_v3.FCStd

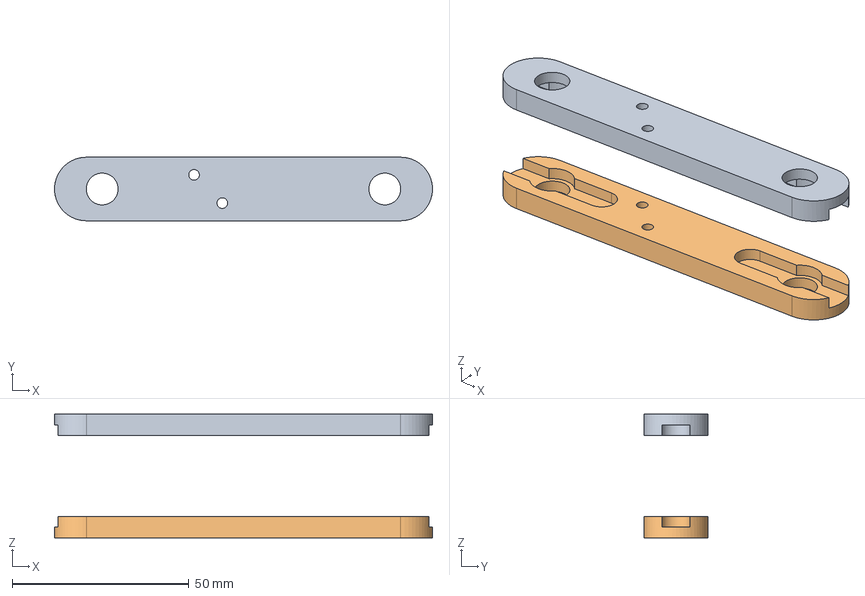
[picture p88: CAD file, 2025-01-04]
Babydoll/Produits/Babybot-01/Mechanical-01/Design hexapod (FreeCAD)/Hexapode_v3/Hexapod_v3.FCStd
107.0 x 18.0 x 35.0 mm
E_2_R
E_2_L
