DorvanFavre/dorvan/Babydoll/Produits/Babybot-01/Mechanical-02/Design Quadruped(Fusion360)/Coxa Bearing.step

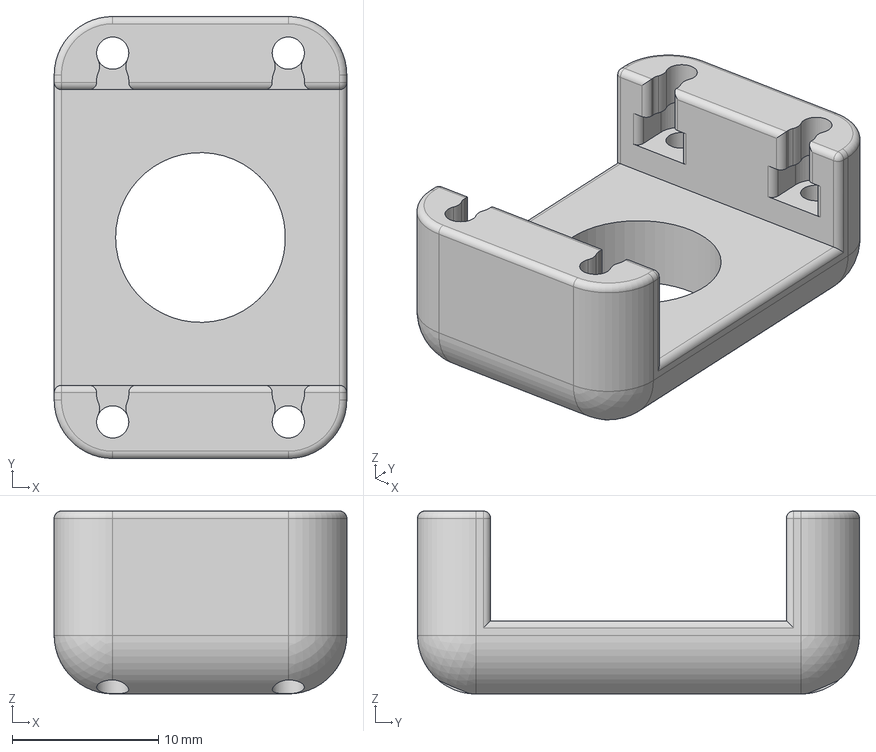
[picture p89: CAD file, 2025-01-30]
Babydoll/Produits/Babybot-01/Mechanical-02/Design Quadruped(Fusion360)/Coxa Bearing.step
20.0 x 30.2 x 12.5 mm
