DorvanFavre/dorvan/Babydoll/Produits/Babybot-01/Mechanical-02/Design Quadruped(Fusion360)/Coxa Top.step

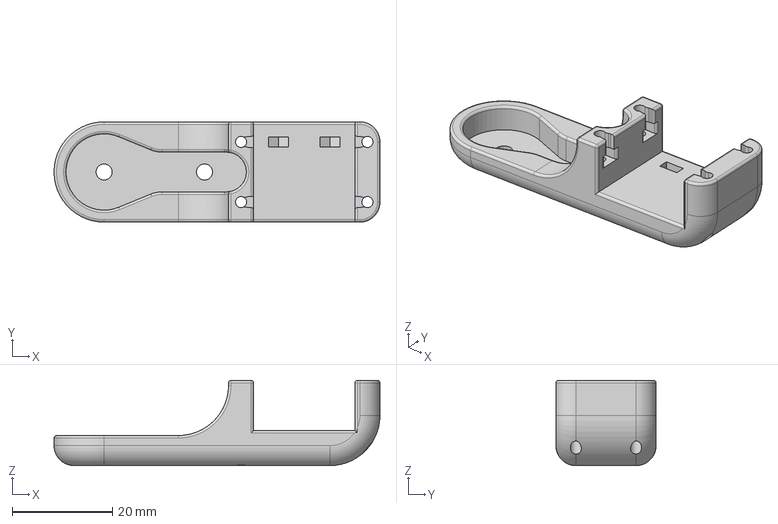
[picture p90: CAD file, 2025-01-30]
Babydoll/Produits/Babybot-01/Mechanical-02/Design Quadruped(Fusion360)/Coxa Top.step
65.0 x 20.0 x 17.0 mm
