DorvanFavre/dorvan/Babydoll/Produits/Babybot-01/Mechanical-02/Design Quadruped(Fusion360)/insert4.step

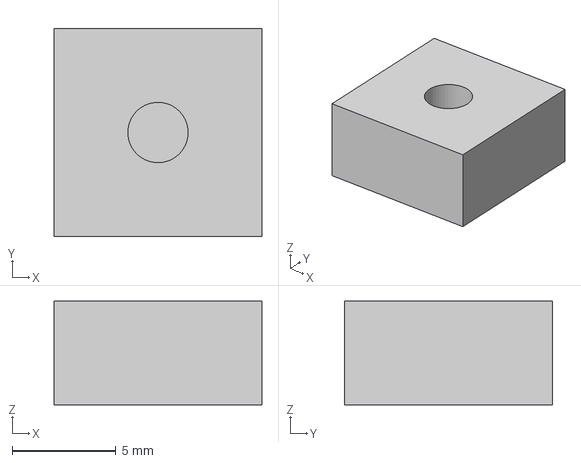
[picture p91: CAD file, 2025-01-30]
Babydoll/Produits/Babybot-01/Mechanical-02/Design Quadruped(Fusion360)/insert4.step
10.0 x 10.0 x 5.00 mm
