DorvanFavre/dorvan/Babydoll/Produits/Babybot-01/Mechanical-02/Design Quadruped(Fusion360)/Coxa Bottom.step

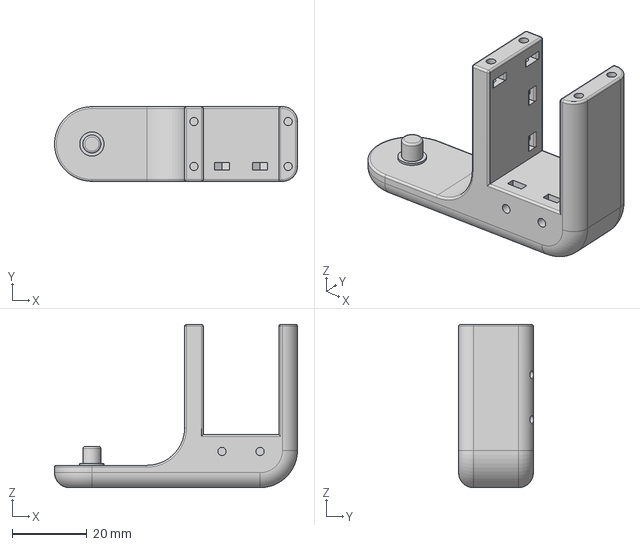
[picture p92: CAD file, 2025-01-30]
Babydoll/Produits/Babybot-01/Mechanical-02/Design Quadruped(Fusion360)/Coxa Bottom.step
65.0 x 20.0 x 43.7 mm
