DorvanFavre/dorvan/Babydoll/Produits/Babybot-01/Mechanical-02/Design Quadruped(Fusion360)/Femur Holder.step

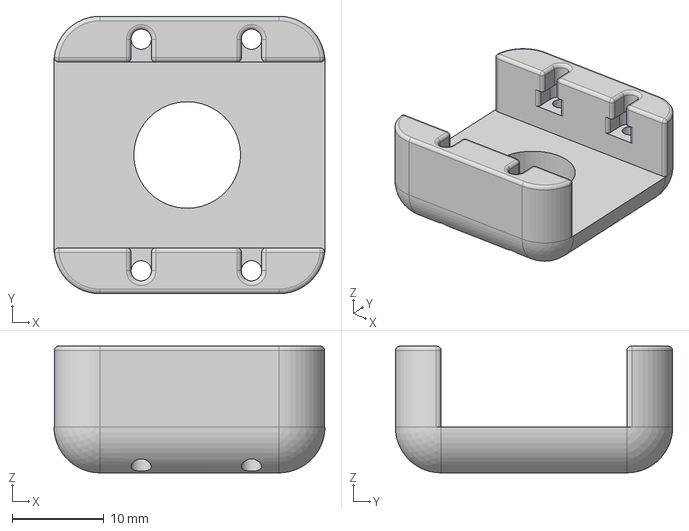
[picture p93: CAD file, 2025-01-18]
Babydoll/Produits/Babybot-01/Mechanical-02/Design Quadruped(Fusion360)/Femur Holder.step
29.5 x 30.2 x 13.8 mm
