DorvanFavre/dorvan/Babydoll/Produits/Babybot-01/Mechanical-02/Design Quadruped(Fusion360)/Femur Bearing.step

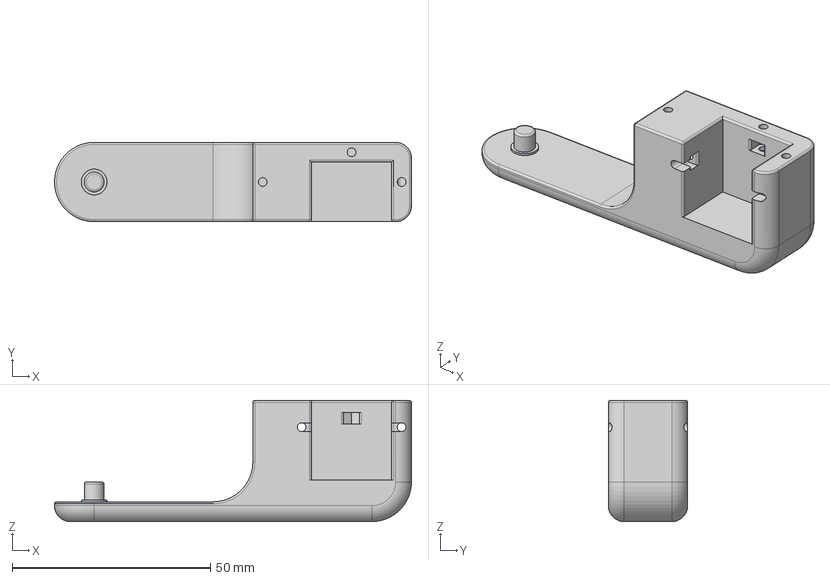
[picture p94: CAD file, 2025-01-18]
Babydoll/Produits/Babybot-01/Mechanical-02/Design Quadruped(Fusion360)/Femur Bearing.step
90.0 x 20.0 x 30.6 mm
