DorvanFavre/dorvan/Babydoll/Produits/Babybot-01/Mechanical-02/Design Quadruped(Fusion360)/Femur Center.step

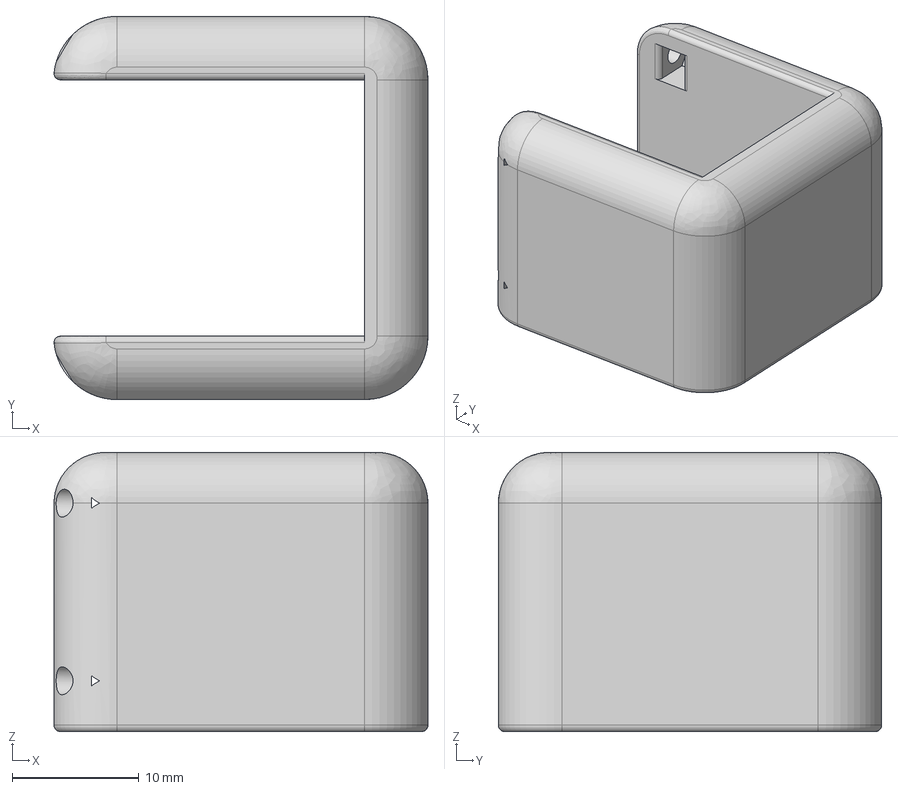
[picture p95: CAD file, 2025-01-18]
Babydoll/Produits/Babybot-01/Mechanical-02/Design Quadruped(Fusion360)/Femur Center.step
29.5 x 30.2 x 22.0 mm
