DorvanFavre/dorvan/(list of files, cad)

Other CAD files:
Babydoll/Produits/Babybot-01/Mechanical-01/Design hexapod (FreeCAD)/Hexapod_v4/E_L_v11.3mf
Babydoll/Produits/Babybot-01/Mechanical-01/Design hexapod (FreeCAD)/Hexapode_v3/E_2_R_v2.stl
Babydoll/Produits/Babybot-01/Mechanical-01/Design hexapod (FreeCAD)/Hexapode_v3/E_2_L_v2.stl
Babydoll/Produits/Babybot-01/Mechanical-01/Design hexapod (FreeCAD)/Hexapode_v3/E_2_L.stl
Babydoll/Produits/Babybot-01/Mechanical-02/Design Quadruped(Fusion360)/nut_test_2mm.step
