DorvanFavre/dorvan/Babydoll/Produits/Babybot-01/Informatic-01/NeuroMechFly/outputs/cpg_controller/three_steps_amp_modulated.png

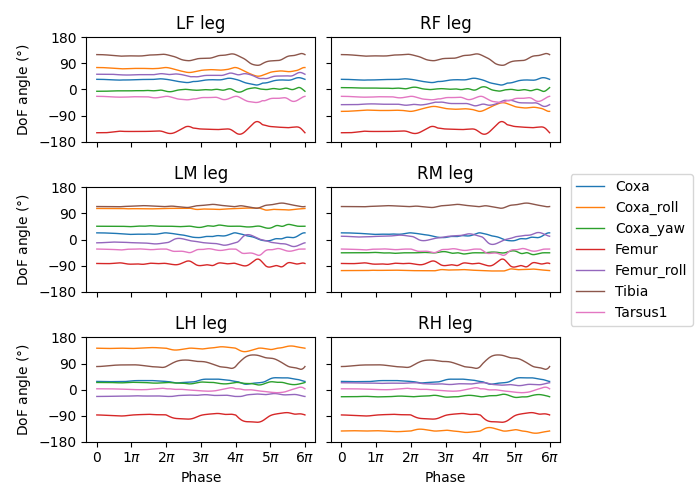
Babydoll/Produits/Babybot-01/Informatic-01/NeuroMechFly/outputs/cpg_controller/three_steps_amp_modulated.png
