DorvanFavre/dorvan/Babydoll/Produits/Babybot-01/Informatic-01/NeuroMechFly/outputs/rule_based_controller/preprogrammed_steps_call.png

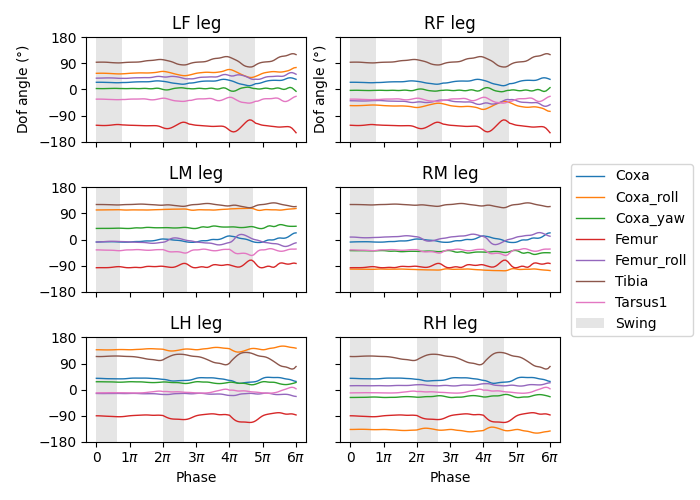
Babydoll/Produits/Babybot-01/Informatic-01/NeuroMechFly/outputs/rule_based_controller/preprogrammed_steps_call.png
