DorvanFavre/dorvan/(commit log)

2024-10-05 Auto-commit on sam. 05 oct. 2024 15:38:23 CEST
    [spline.stl]
2024-10-08 Auto-commit on mar. 08 oct. 2024 07:54:44 CEST
    [Round.stl, boulon.stl, hole.stl, hole2.stl, piece_01.stl, piece_01_2.stl, piece_01_3.stl, piece_01_4.stl]
2024-10-08 Auto-commit on mar. 08 oct. 2024 21:56:14 CEST
    [piece_03_AB.stl, piece_03_AB_2.stl]
2024-10-09 Auto-commit on mer. 09 oct. 2024 20:05:32 CEST
    [04_triangle.FCStd, 05_round.FCStd, 06_cooker.FCStd, 07_sweep.FCStd, first-BodyFillet002.stl, first.FCStd, vid_03.FCStd]
2024-10-13 Auto-commit on dim. 13 oct. 2024 08:55:47 CEST
    [08_quille.FCStd, 09_boxes.FCStd, 10_surface.FCStd, 11_surface_2.FCStd, 12_lofting.FCStd, 13_profile.FCStd, 14_master_sketch.FCStd, 14_pipe.FCStd]
2024-10-14 Auto-commit on lun. 14 oct. 2024 11:52:44 CEST
    [A.stl, B.stl, C.stl, D.stl, Hexapod.FCStd, Piece01.stl, Spline_1.stl, WholeTest.FCStd]
2024-10-14 Auto-commit on lun. 14 oct. 2024 15:08:57 CEST
    [E.stl, Hexapod.FCStd, SplineTest.stl, SplineTest3.stl]
2024-10-15 Auto-commit on mar. 15 oct. 2024 18:16:44 CEST
    [D.stl, E.stl, E2.stl, F.stl, Hexapod.FCStd, X.stl]
2024-10-16 Auto-commit on mer. 16 oct. 2024 14:47:59 CEST
    [A_R.stl, A_v2.stl, B_v2.stl, B_v3.stl, C_v2.stl, C_v3.stl, C_v4.stl, D_v2.stl]
2024-10-16 Auto-commit on mer. 16 oct. 2024 17:53:59 CEST
    [F_v2.stl, Hexapod.FCStd]
2024-10-18 Auto-commit on ven. 18 oct. 2024 14:15:16 CEST
    [A_R_v2.stl, C_v5.stl, C_v6.stl, C_v7.stl, D_v3.stl, D_v4.stl, E_v4.stl, E_v5.stl]
2024-10-18 Auto-commit on ven. 18 oct. 2024 14:49:14 CEST
    [Hexapod.FCStd, Hexapod_v2.FCStd]
2024-10-19 Auto-commit on sam. 19 oct. 2024 19:09:06 CEST
    [Hexapod_v2.FCStd]
2024-10-20 Auto-commit on dim. 20 oct. 2024 18:13:29 CEST
    [BallBearing_v1.stl, BallBearing_v2.stl, FootHolder_v1.stl, Hexapod_v2.FCStd, Hexapod_v3.FCStd, Spline_1.stl]
2024-10-21 Auto-commit on lun. 21 oct. 2024 11:55:47 CEST
    [FootHolder_v2.stl, Foot_v1.stl, Hexapod_v3.FCStd]
2024-10-21 Auto-commit on lun. 21 oct. 2024 14:12:45 CEST
    [Foot_v2.stl, Hexapod_v3.FCStd]
2024-10-22 Auto-commit on mar. 22 oct. 2024 17:15:47 CEST
    [G_R_v1.stl, G_v1.stl, G_v2.stl, G_v3.stl, Hexapod_v3.FCStd, TibiaBB_v1.stl, TibiaBB_v2.stl, TibiaHolder_v2.stl]
2024-10-22 Auto-commit on mar. 22 oct. 2024 18:40:51 CEST
    [H_R_v1.stl, Hexapod_v3.FCStd]
2024-10-24 Auto-commit on jeu. 24 oct. 2024 12:52:26 CEST
    [B_v1.stl, C_v1.stl, Hexapod_v3.FCStd, I_v1.stl, I_v2.stl, J_v1.stl]
2024-10-28 Auto-commit on lun. 28 oct. 2024 16:10:54 CET
    [A_R_v10.stl, B_R_v10.stl, C_v10.stl, D_R_v10.stl, E_R_v10.stl, F_R_v10.stl, G_R_v10.stl, H_R_v10.stl]
2024-10-30 Auto-commit on mer. 30 oct. 2024 16:37:53 CET
    [04_triangle.FCStd, 05_round.FCStd, 06_cooker.FCStd, 07_sweep.FCStd, 08_quille.FCStd, 09_boxes.FCStd, 10_surface.FCStd, 11_surface_2.FCStd]
2024-10-31 Auto-commit on jeu. 31 oct. 2024 18:42:11 CET
    [cartpole.urdf, hexapod copy.urdf, hexapod.urdf, hexapod_2.urdf, husky.urdf, mill.urdf]
2024-11-05 Auto-commit on Tue Nov 5 09:30:19 PM CET 2024
    [A_L_v11.stl, D_L_v11.stl, E_L_v11.stl, F_L_v11.stl, G_L_v11.stl, H_L_v11.stl, Hexapod_v4.FCStd, K_v11.stl]
2024-11-11 Auto-commit on Mon Nov 11 01:31:49 PM CET 2024
    [Hexapod_v4.FCStd]
2024-11-12 Auto-commit on Tue Nov 12 09:06:12 PM CET 2024
    [04_triangle.FCStd, 05_round.FCStd, 06_cooker.FCStd, 07_sweep.FCStd, 08_quille.FCStd, 09_boxes.FCStd, 10_surface.FCStd, 11_surface_2.FCStd]
2024-11-14 Auto-commit on Thu Nov 14 04:44:37 PM CET 2024
    [hexapod.urdf]
2024-11-21 Auto-commit on 21 نوفمبر, 2024 CET 10:22:16 ص
    [04_triangle.FCStd, 05_round.FCStd, 06_cooker.FCStd, 07_sweep.FCStd, 08_quille.FCStd, 09_boxes.FCStd, 10_surface.FCStd, 11_surface_2.FCStd]
2024-11-21 Auto-commit on 21 نوفمبر, 2024 CET 07:02:16 م
2024-11-21 Deleted folder_name
    [04_triangle.FCStd, 05_round.FCStd, 06_cooker.FCStd, 07_sweep.FCStd, 08_quille.FCStd, 09_boxes.FCStd, 10_surface.FCStd, 11_surface_2.FCStd]
2024-11-21 Auto-commit on 21 نوفمبر, 2024 CET 07:10:38 م
2024-11-21 Auto-commit on Do 21 Nov 2024 19:43:27 CET
    [pyvenv.cfg]
2024-11-21 Auto-commit on Do 21 Nov 2024 19:46:52 CET
    [pyvenv.cfg]
2024-11-28 Auto-commit on Thu 28 Nov 16:15:10 CET 2024
    [hexapod_2.urdf, sphere.urdf, textured_sphere_smooth.obj]
2024-12-04 Auto-commit on Wed 4 Dec 16:10:49 CET 2024
    [hexapod_2.urdf]
2024-12-31 Auto-commit on Tue 31 Dec 18:16:16 CET 2024
    [6xE.3mf, E_L_v11.3mf]
2025-01-04 Auto-commit on Sat 4 Jan 19:21:34 CET 2025
    [E_2_L.stl, E_2_L_v2.stl, E_2_R.stl, E_2_R_v2.stl, Hexapod_v3.FCStd]
2025-01-18 j
    mujgkghj
    [C_v11.3mf, Femur Bearing.step, Femur Center.step, Femur Holder.step, Femur Spline.step, hexapod.urdf]
2025-01-30 asd
    sdasd
    [Coxa Bearing.step, Coxa Bottom.step, Coxa Top.step, Femur Bearing.step, Femur Center.step, Femur Holder.step, Femur Spline.step, Tests v1.step]
